benlamonica/drone-show/README.md

# drone-show
The code used for my amateur drone show quad-copters
