benlamonica/drone-show/frame/out/hub.png

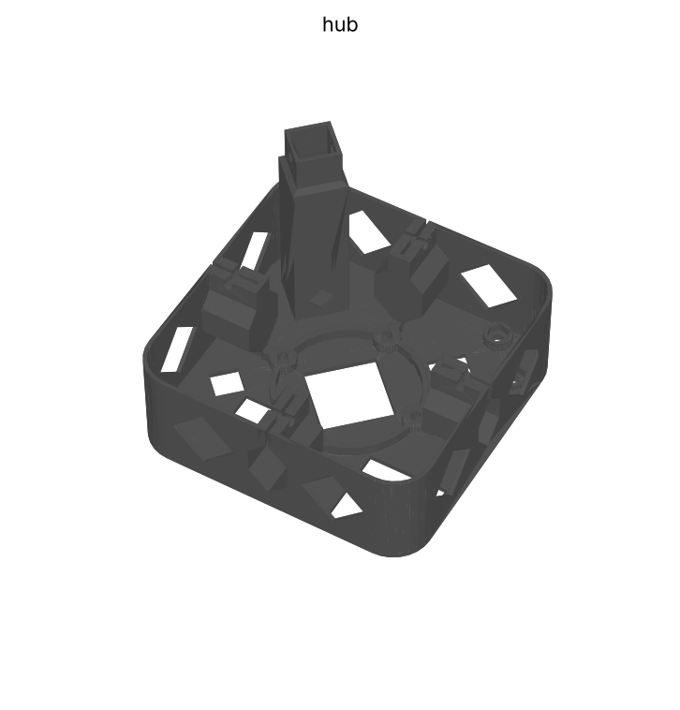
frame/out/hub.png
