benlamonica/drone-show/frame/out/motor_pod.png

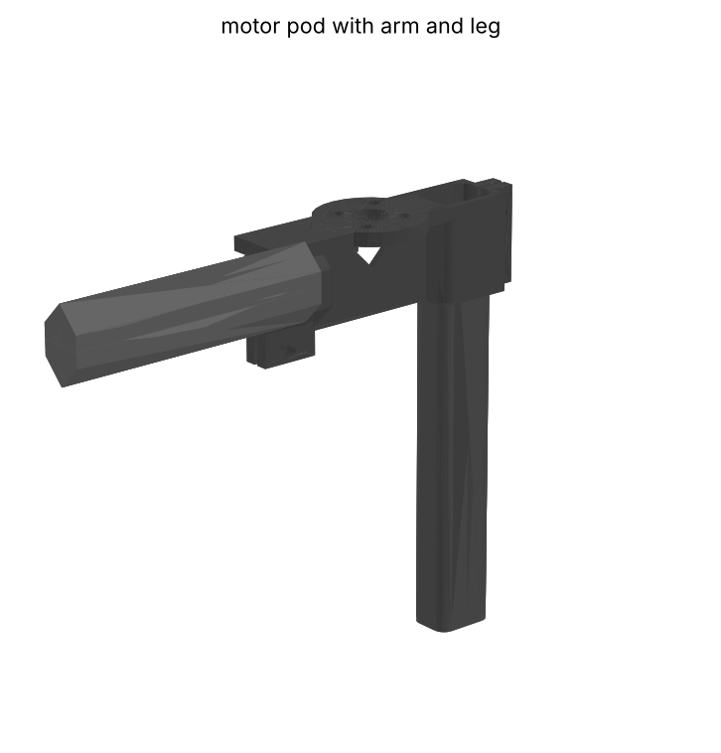
frame/out/motor_pod.png
