benlamonica/drone-show/frame/out/side.png

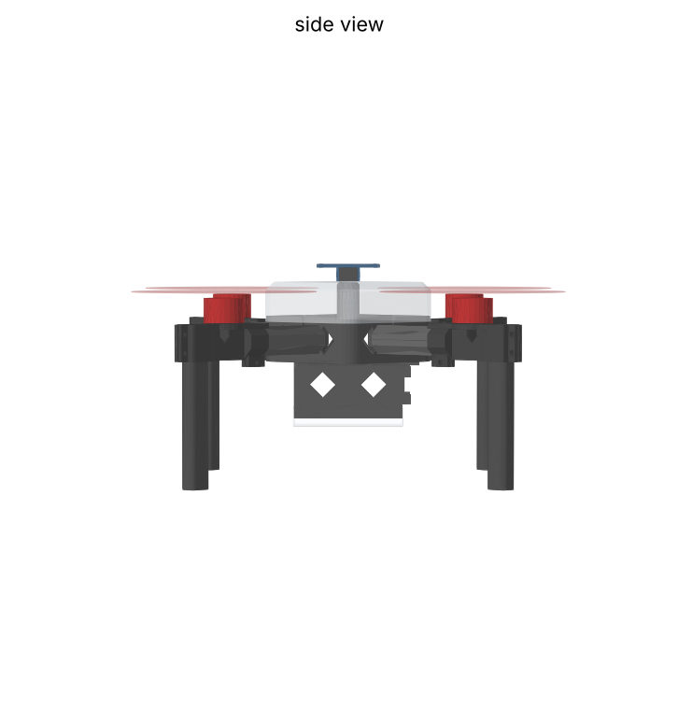
frame/out/side.png
