benlamonica/drone-show/hardware/flight-controller/images/bottom.png

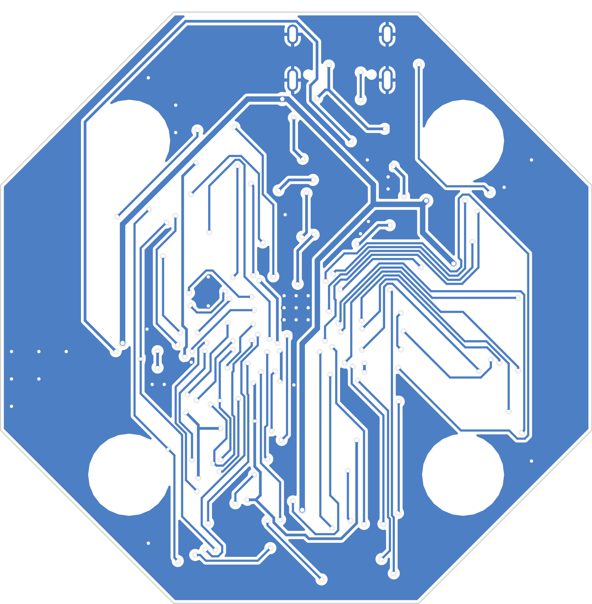
hardware/flight-controller/images/bottom.png
