benlamonica/drone-show/hardware/flight-controller/images/top.png

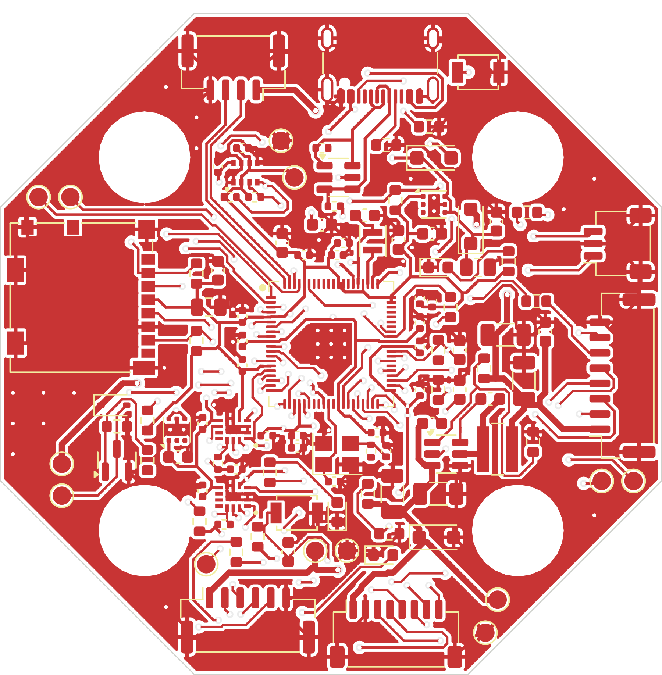
hardware/flight-controller/images/top.png
