benlamonica/drone-show/hardware/light-controller/images/bottom.png

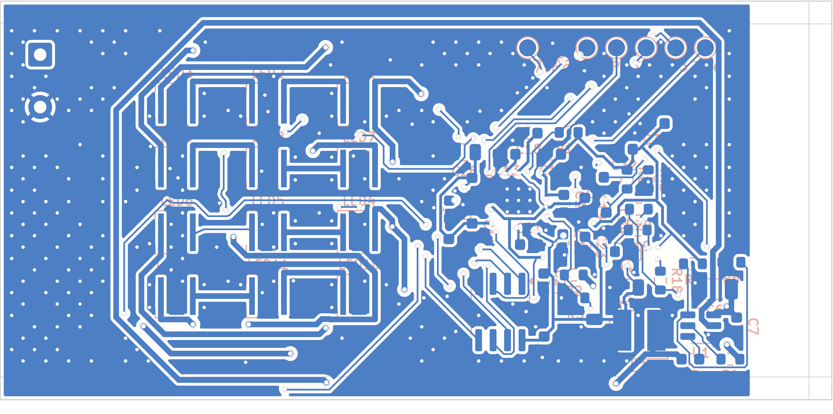
hardware/light-controller/images/bottom.png
