benlamonica/drone-show/hardware/rtk-gps/fab/render-bottom.png

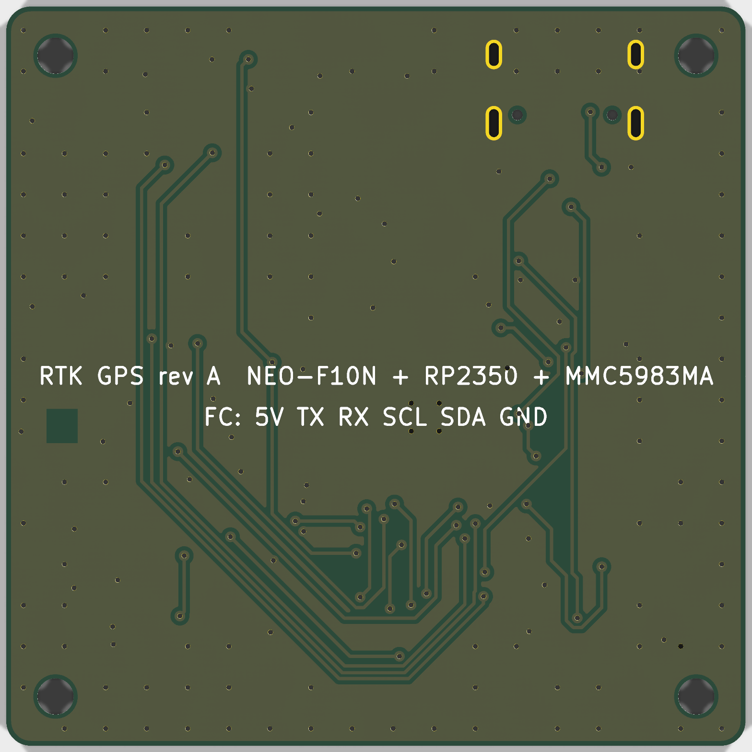
hardware/rtk-gps/fab/render-bottom.png
