benlamonica/drone-show/hardware/rtk-gps/fab/render-top.png

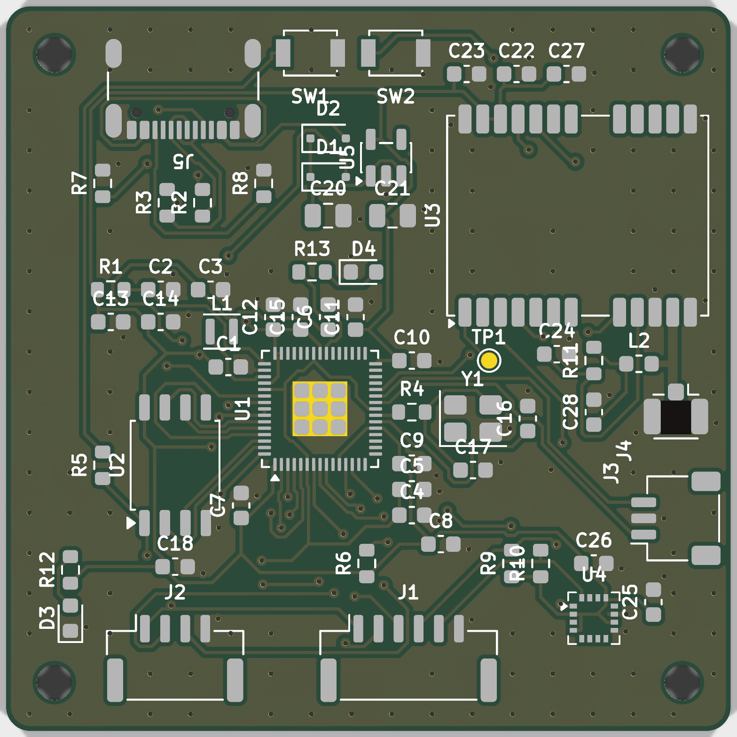
hardware/rtk-gps/fab/render-top.png
