benlamonica/drone-show/hardware/rtk-gps/fab/rtk_gps-bom.csv

Designator | Value | Footprint | MPN | Manufacturer | Mouser | Qty
C1-C3 | 4.7uF | Capacitor_SMD:C_0603_1608Metric | CL10A475MO8NNNC | Samsung | 187-CL10A475MO8NNNC | 3
C4-C15,C18,C22,C27,C28 | 100nF | Capacitor_SMD:C_0603_1608Metric | CC0603KRX7R7BB104 | Yageo | 603-CC603KRX7R7BB104 | 16
C16,C17 | 15pF | Capacitor_SMD:C_0603_1608Metric | CC0603JRNPO9BN150 | Yageo | 603-CC603JRNPO9BN150 | 2
C20,C21 | 10uF | Capacitor_SMD:C_0805_2012Metric | CC0805KKX5R7BB106 | Yageo | 603-CC805KKX5R7BB106 | 2
C23,C26 | 10uF | Capacitor_SMD:C_0603_1608Metric | LMK107BBJ106MALT | Taiyo Yuden | 963-LMK107BBJ106MALT | 2
C24 | 10nF | Capacitor_SMD:C_0603_1608Metric | CC0603KRX7R9BB103 | Yageo | 603-CC603KRX7R9BB103 | 1
C25 | 1uF | Capacitor_SMD:C_0603_1608Metric | CC0603KRX7R7BB105 | Yageo | 603-CC603KRX7R7BB105 | 1
D1,D2 | PMEG4010CEJ | Diode_SMD:D_SOD-323F | PMEG4010CEJ,115 | Nexperia | 771-PMEG4010CEJ-T/R | 2
D3 | green | LED_SMD:LED_0603_1608Metric | LTST-C191KGKT | Lite-On | 859-LTST-C191KGKT | 1
D4 | blue | LED_SMD:LED_0603_1608Metric | LTST-C191TBKT | Lite-On | 859-LTST-C191TBKT | 1
J1 | FC GPS port (Pixhawk GH-6) | Connector_JST:JST_GH_SM06B-GHS-TB_1x06-1MP_P1.25mm_Horizontal | SM06B-GHS-TB(LF)(SN) | JST | 306-SM06BGHSTBLFSN | 1
J2 | AUX UART (corrections in) | Connector_JST:JST_GH_SM04B-GHS-TB_1x04-1MP_P1.25mm_Horizontal | SM04B-GHS-TB(LF)(SN) | JST | 306-SM04BGHSTBLFSN | 1
J3 | SWD (Pi debug probe) | Connector_JST:JST_SH_SM03B-SRSS-TB_1x03-1MP_P1.00mm_Horizontal | SM03B-SRSS-TB(LF)(SN) | JST | 306-SM03BSRSSTBLFSNP | 1
J4 | U.FL antenna | Connector_Coaxial:U.FL_Hirose_U.FL-R-SMT-1_Vertical | U.FL-R-SMT-1(10) | Hirose | 798-U.FL-R-SMT-1-10 | 1
J5 | USB-C (flash + debug) | Connector_USB:USB_C_Receptacle_GCT_USB4105-xx-A_16P_TopMnt_Horizontal | USB4105-GF-A | GCT | 640-USB4105-GF-A | 1
L1 | 3.3uH | Inductor_SMD:L_Murata_DFE201610P | AOTA-B201610S3R3-101-T | Abracon | 815-AB201610S3R3101T | 1
L2 | 27nH | Inductor_SMD:L_0603_1608Metric | LQG18HN27NJ00D | Murata | 81-LQG18HN27NJ00D | 1
R1 | 33R | Resistor_SMD:R_0603_1608Metric | RC0603FR-0733RL | Yageo | 603-RC0603FR-0733RL | 1
R2,R3 | 27R | Resistor_SMD:R_0603_1608Metric | RC0603FR-0727RL | Yageo | 603-RC0603FR-0727RL | 2
R4,R5,R12,R13 | 1k | Resistor_SMD:R_0603_1608Metric | RC0603FR-071KL | Yageo | 603-RC0603FR-071KL | 4
R6 | 10k | Resistor_SMD:R_0603_1608Metric | RC0603FR-0710KL | Yageo | 603-RC0603FR-0710KL | 1
R7,R8 | 5.1k | Resistor_SMD:R_0603_1608Metric | RC0603FR-075K1L | Yageo | 603-RC0603FR-075K1L | 2
R9,R10 | 2.2k | Resistor_SMD:R_0603_1608Metric | RC0603FR-072K2L | Yageo | 603-RC0603FR-072K2L | 2
R11 | 10R | Resistor_SMD:R_0603_1608Metric | RC0603FR-0710RL | Yageo | 603-RC0603FR-0710RL | 1
SW1 | BOOTSEL | Button_Switch_SMD:SW_SPST_B3U-1000P | B3U-1000P | Omron | 653-B3U-1000P | 1
SW2 | RESET | Button_Switch_SMD:SW_SPST_B3U-1000P | B3U-1000P | Omron | 653-B3U-1000P | 1
U1 | RP2350A | Package_DFN_QFN:QFN-60-1EP_7x7mm_P0.4mm_EP3.4x3.4mm | SC1509-A4 (RP2350A) | Raspberry Pi | 358-SC1509 | 1
U2 | W25Q32JVSS | Package_SO:SOIC-8_5.3x5.3mm_P1.27mm | W25Q32JVSSIQ | Winbond | 454-W25Q32JVSSIQ | 1
U3 | NEO-F10N-00B-20 | RF_GPS:ublox_NEO | NEO-F10N-00B-20 | u-blox | 377-NEO-F10N-00B-20 | 1
U4 | MMC5983MA | Package_LGA:LGA-16_3x3mm_P0.5mm | MMC5983MA | MEMSIC | 438-MMC5983MA | 1
U5 | AP2112K-3.3 | Package_TO_SOT_SMD:SOT-23-5 | AP2112K-3.3TRG1 | Diodes Inc | 621-AP2112K-3.3TRG1 | 1
Y1 | 12MHz | Crystal:Crystal_SMD_3225-4Pin_3.2x2.5mm | ABM8-272-T3 | Abracon | 815-ABM8-272-T3 | 1
