benlamonica/drone-show/frame/out/assembly.step

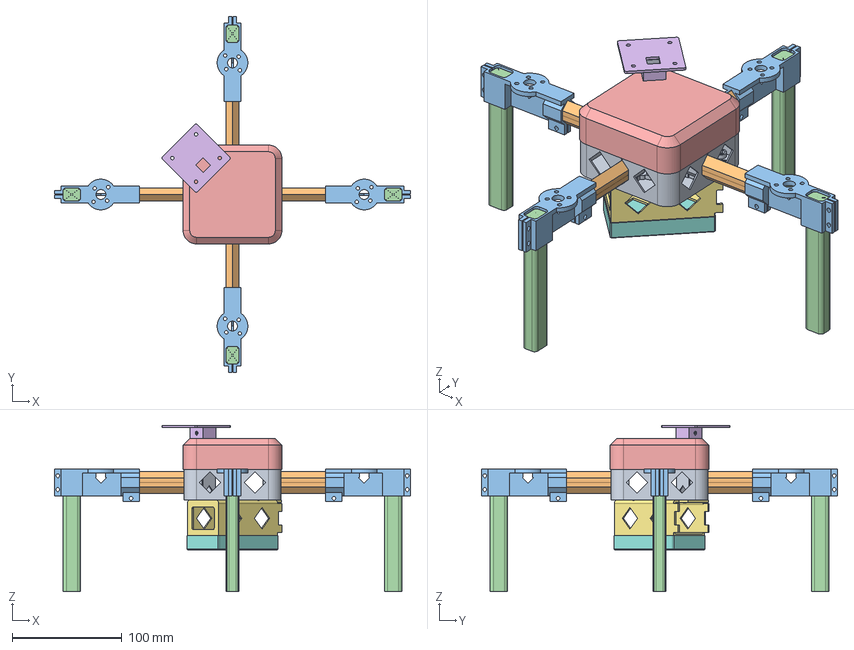
[picture p14: CAD file, 2026-10-25]
frame/out/assembly.step
324.6 x 324.6 x 151.6 mm
