benlamonica/drone-show/frame/out/leg.step

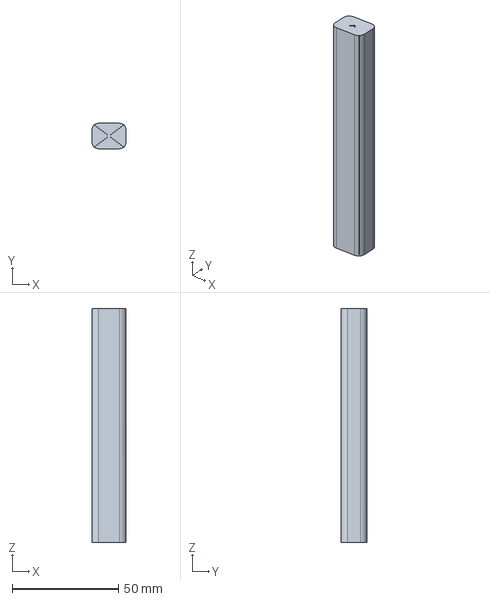
[picture p15: CAD file, 2026-10-25]
frame/out/leg.step
16.0 x 12.0 x 110.0 mm
