benlamonica/drone-show/hardware/rtk-gps/fab/rtk_gps.step

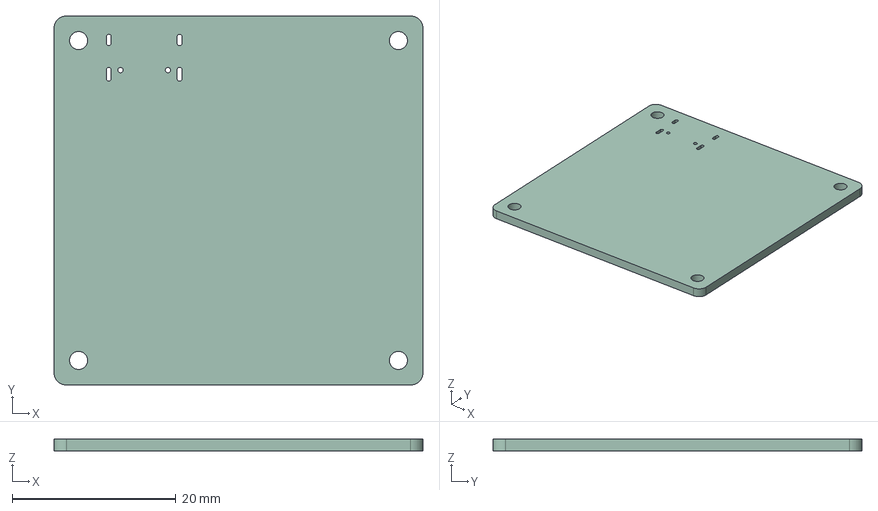
[picture p16: CAD file, 2026-10-25]
hardware/rtk-gps/fab/rtk_gps.step
45.0 x 45.0 x 1.51 mm
