benlamonica/drone-show/frame/out/hub.step

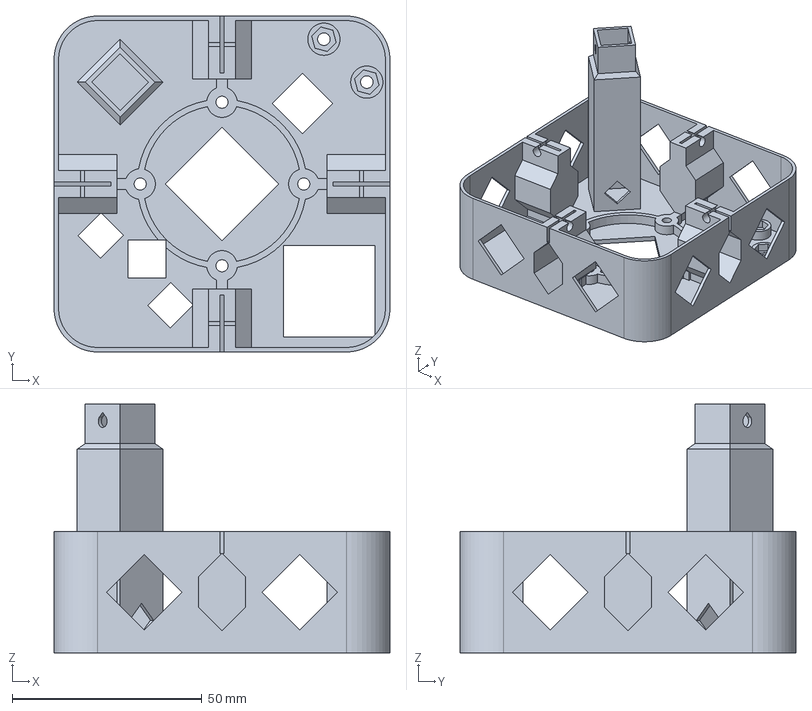
[picture p17: CAD file, 2026-10-25]
frame/out/hub.step
88.6 x 88.6 x 65.6 mm
