benlamonica/drone-show/frame/out/motor_pod.step

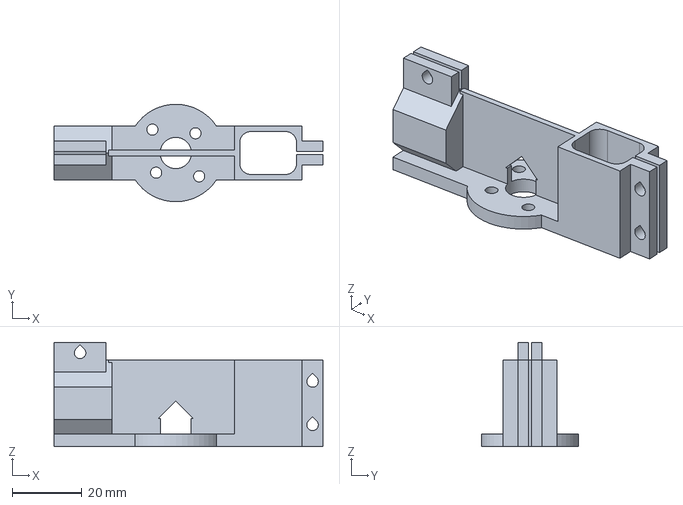
[picture p18: CAD file, 2026-10-25]
frame/out/motor_pod.step
77.3 x 28.0 x 29.9 mm
