benlamonica/drone-show/frame/out/battery_bay.step

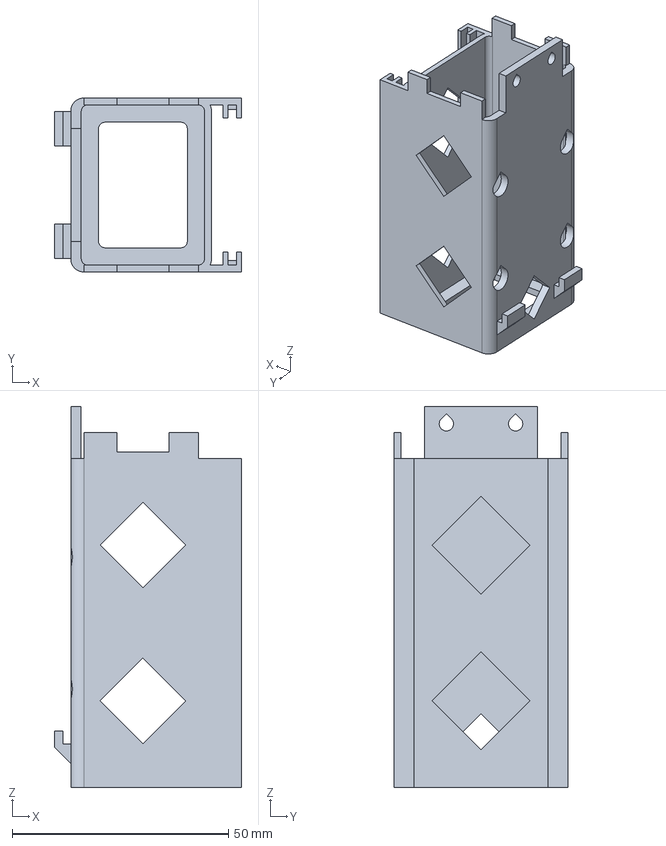
[picture p19: CAD file, 2026-10-25]
frame/out/battery_bay.step
43.3 x 40.2 x 88.0 mm
