benlamonica/drone-show/frame/out/light_diffuser_vase.step

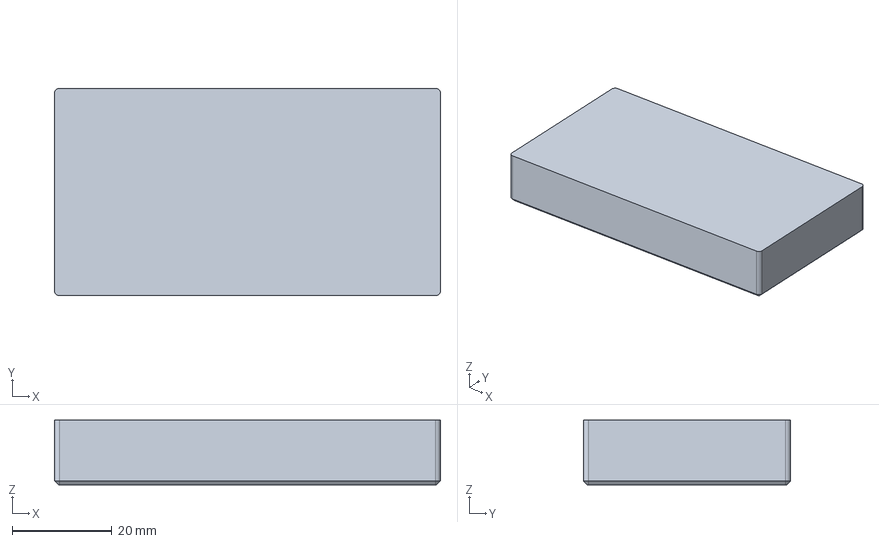
[picture p20: CAD file, 2026-10-25]
frame/out/light_diffuser_vase.step
77.4 x 41.6 x 13.0 mm
