benlamonica/drone-show/frame/out/top_shell_vase.step

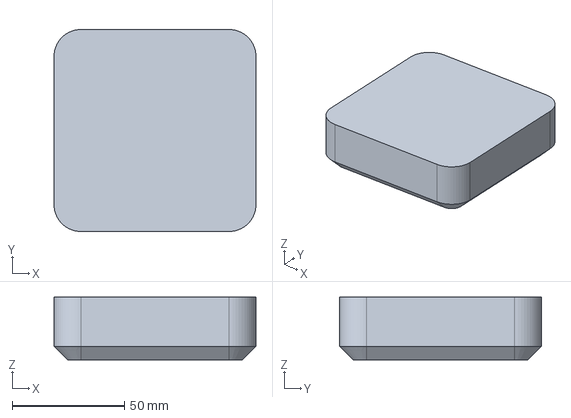
[picture p21: CAD file, 2026-10-25]
frame/out/top_shell_vase.step
90.0 x 90.0 x 28.0 mm
