benlamonica/drone-show/frame/out/light_pcb_outline.dxf

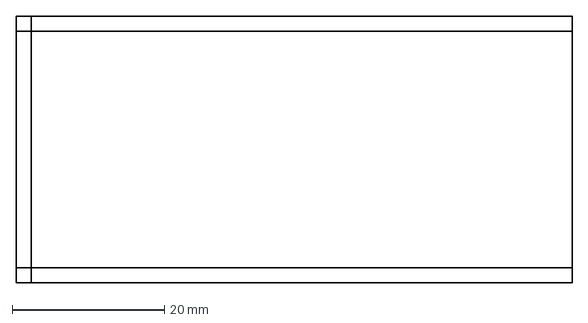
[picture p22: CAD file, 2026-10-25]
frame/out/light_pcb_outline.dxf
73.0 x 35.0 mm
