benlamonica/drone-show/frame/out/arm.step

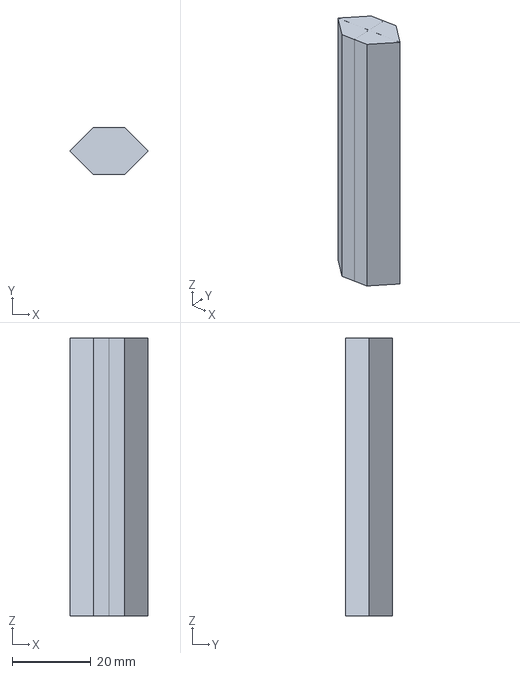
[picture p23: CAD file, 2026-10-25]
frame/out/arm.step
20.0 x 12.0 x 70.7 mm
