benlamonica/drone-show/frame/out/gps_cap.step

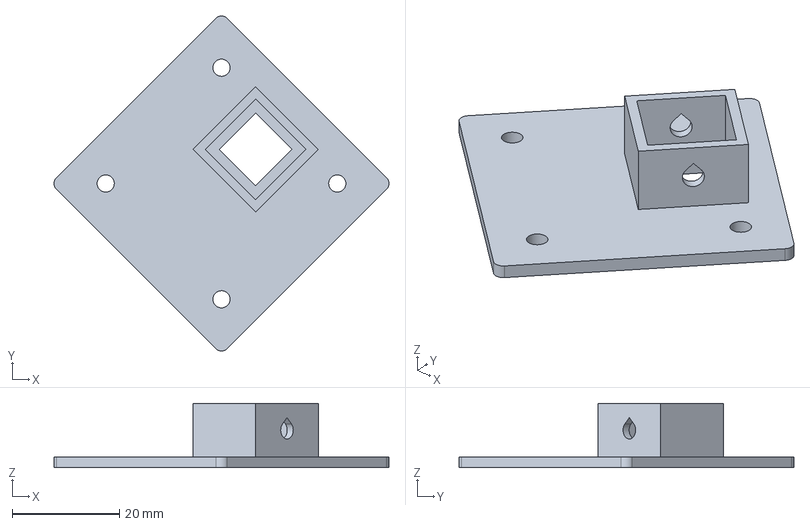
[picture p24: CAD file, 2026-10-25]
frame/out/gps_cap.step
62.4 x 62.4 x 12.0 mm
