benlamonica/drone-show/(list of files, cad)

Other CAD files:
frame/out/arm.stl
frame/out/battery_bay.stl
frame/out/gps_cap.stl
frame/out/hub.stl
frame/out/leg.stl
frame/out/light_diffuser_vase.stl
frame/out/motor_pod.stl
frame/out/top_shell_vase.stl
