benlamonica/drone-show/hardware/rtk-gps/fab/rtk_gps-schematic.pdf

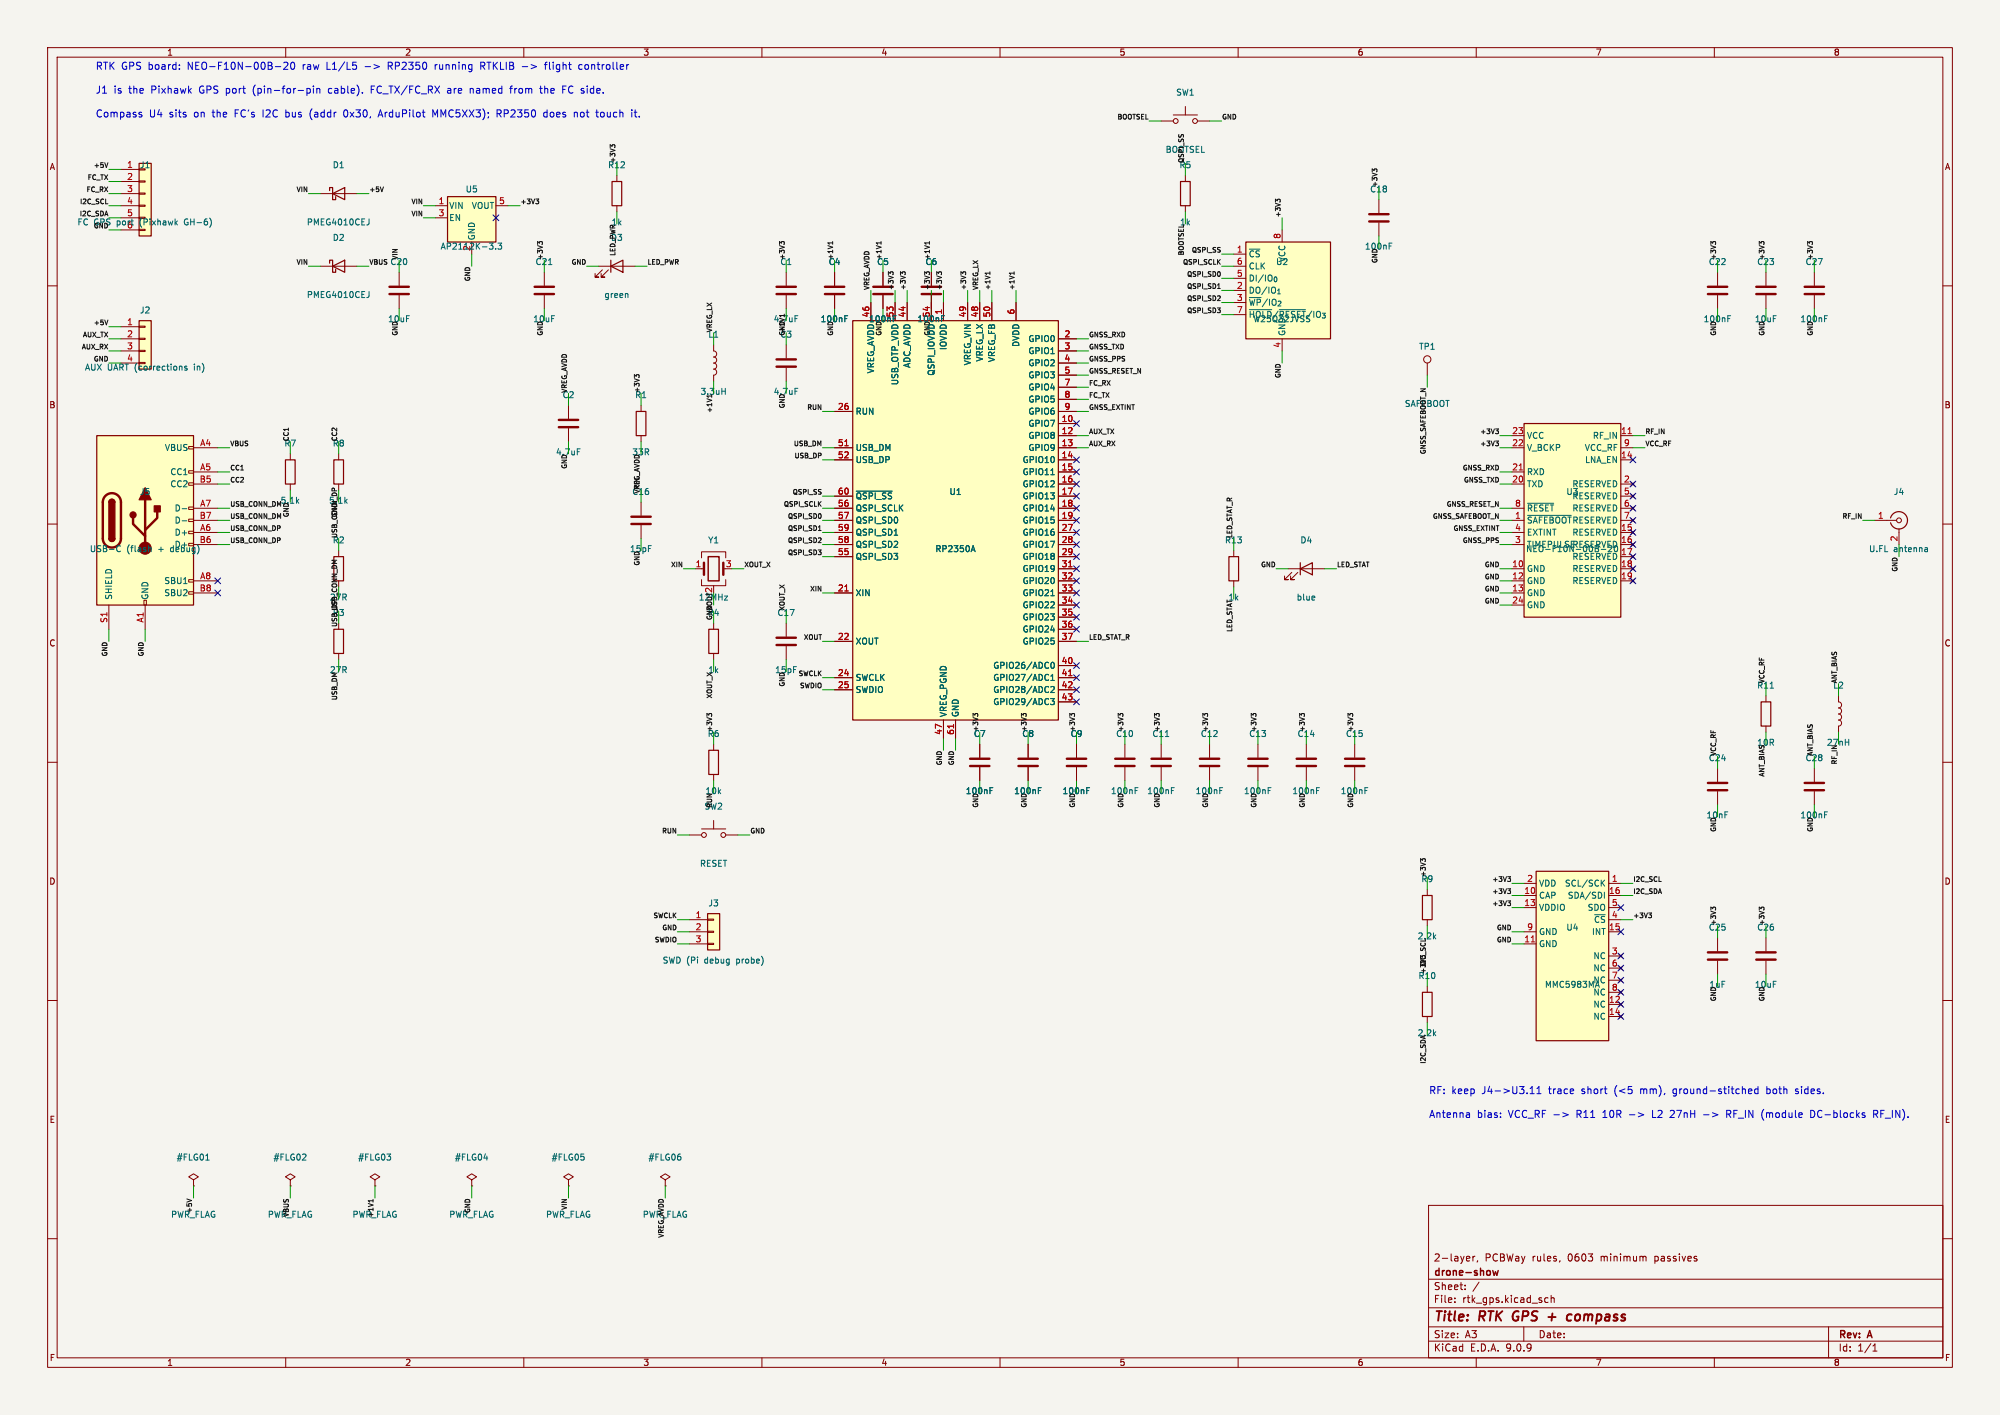
[picture p25: page 1]

6 RUN 26 USB_DM 51 USB_DP 52 ~{QSPI_SS} 60 QSPI_SCLK 56 QSPI_SD0 57 QSPI_SD1 59 QSPI_SD2 58 QSPI_SD3 55 XIN 21 XOUT 22 SWCLK 24 SWDIO 25 ADC_AVDD 44 IOVDD

J3 SWD (Pi debug probe)
SWCLK GND

INT 15 NC 3 NC 6 NC 7 NC 8 NC 12 NC 14 U4 MMC5983MA

File: rtk_gps.kicad_sch Sheet: / drone-show

Id: 1/1 Title: RTK GPS + compass
