benlamonica/drone-show/(list of files, drawings)

Other design files:
hardware/rtk-gps/rtk_gps.dsn
