benlamonica/drone-show/hardware/light-controller/light-controller.kicad_pcb

## KiCad design hardware/light-controller/light-controller.kicad_pcb (2026-11-08)

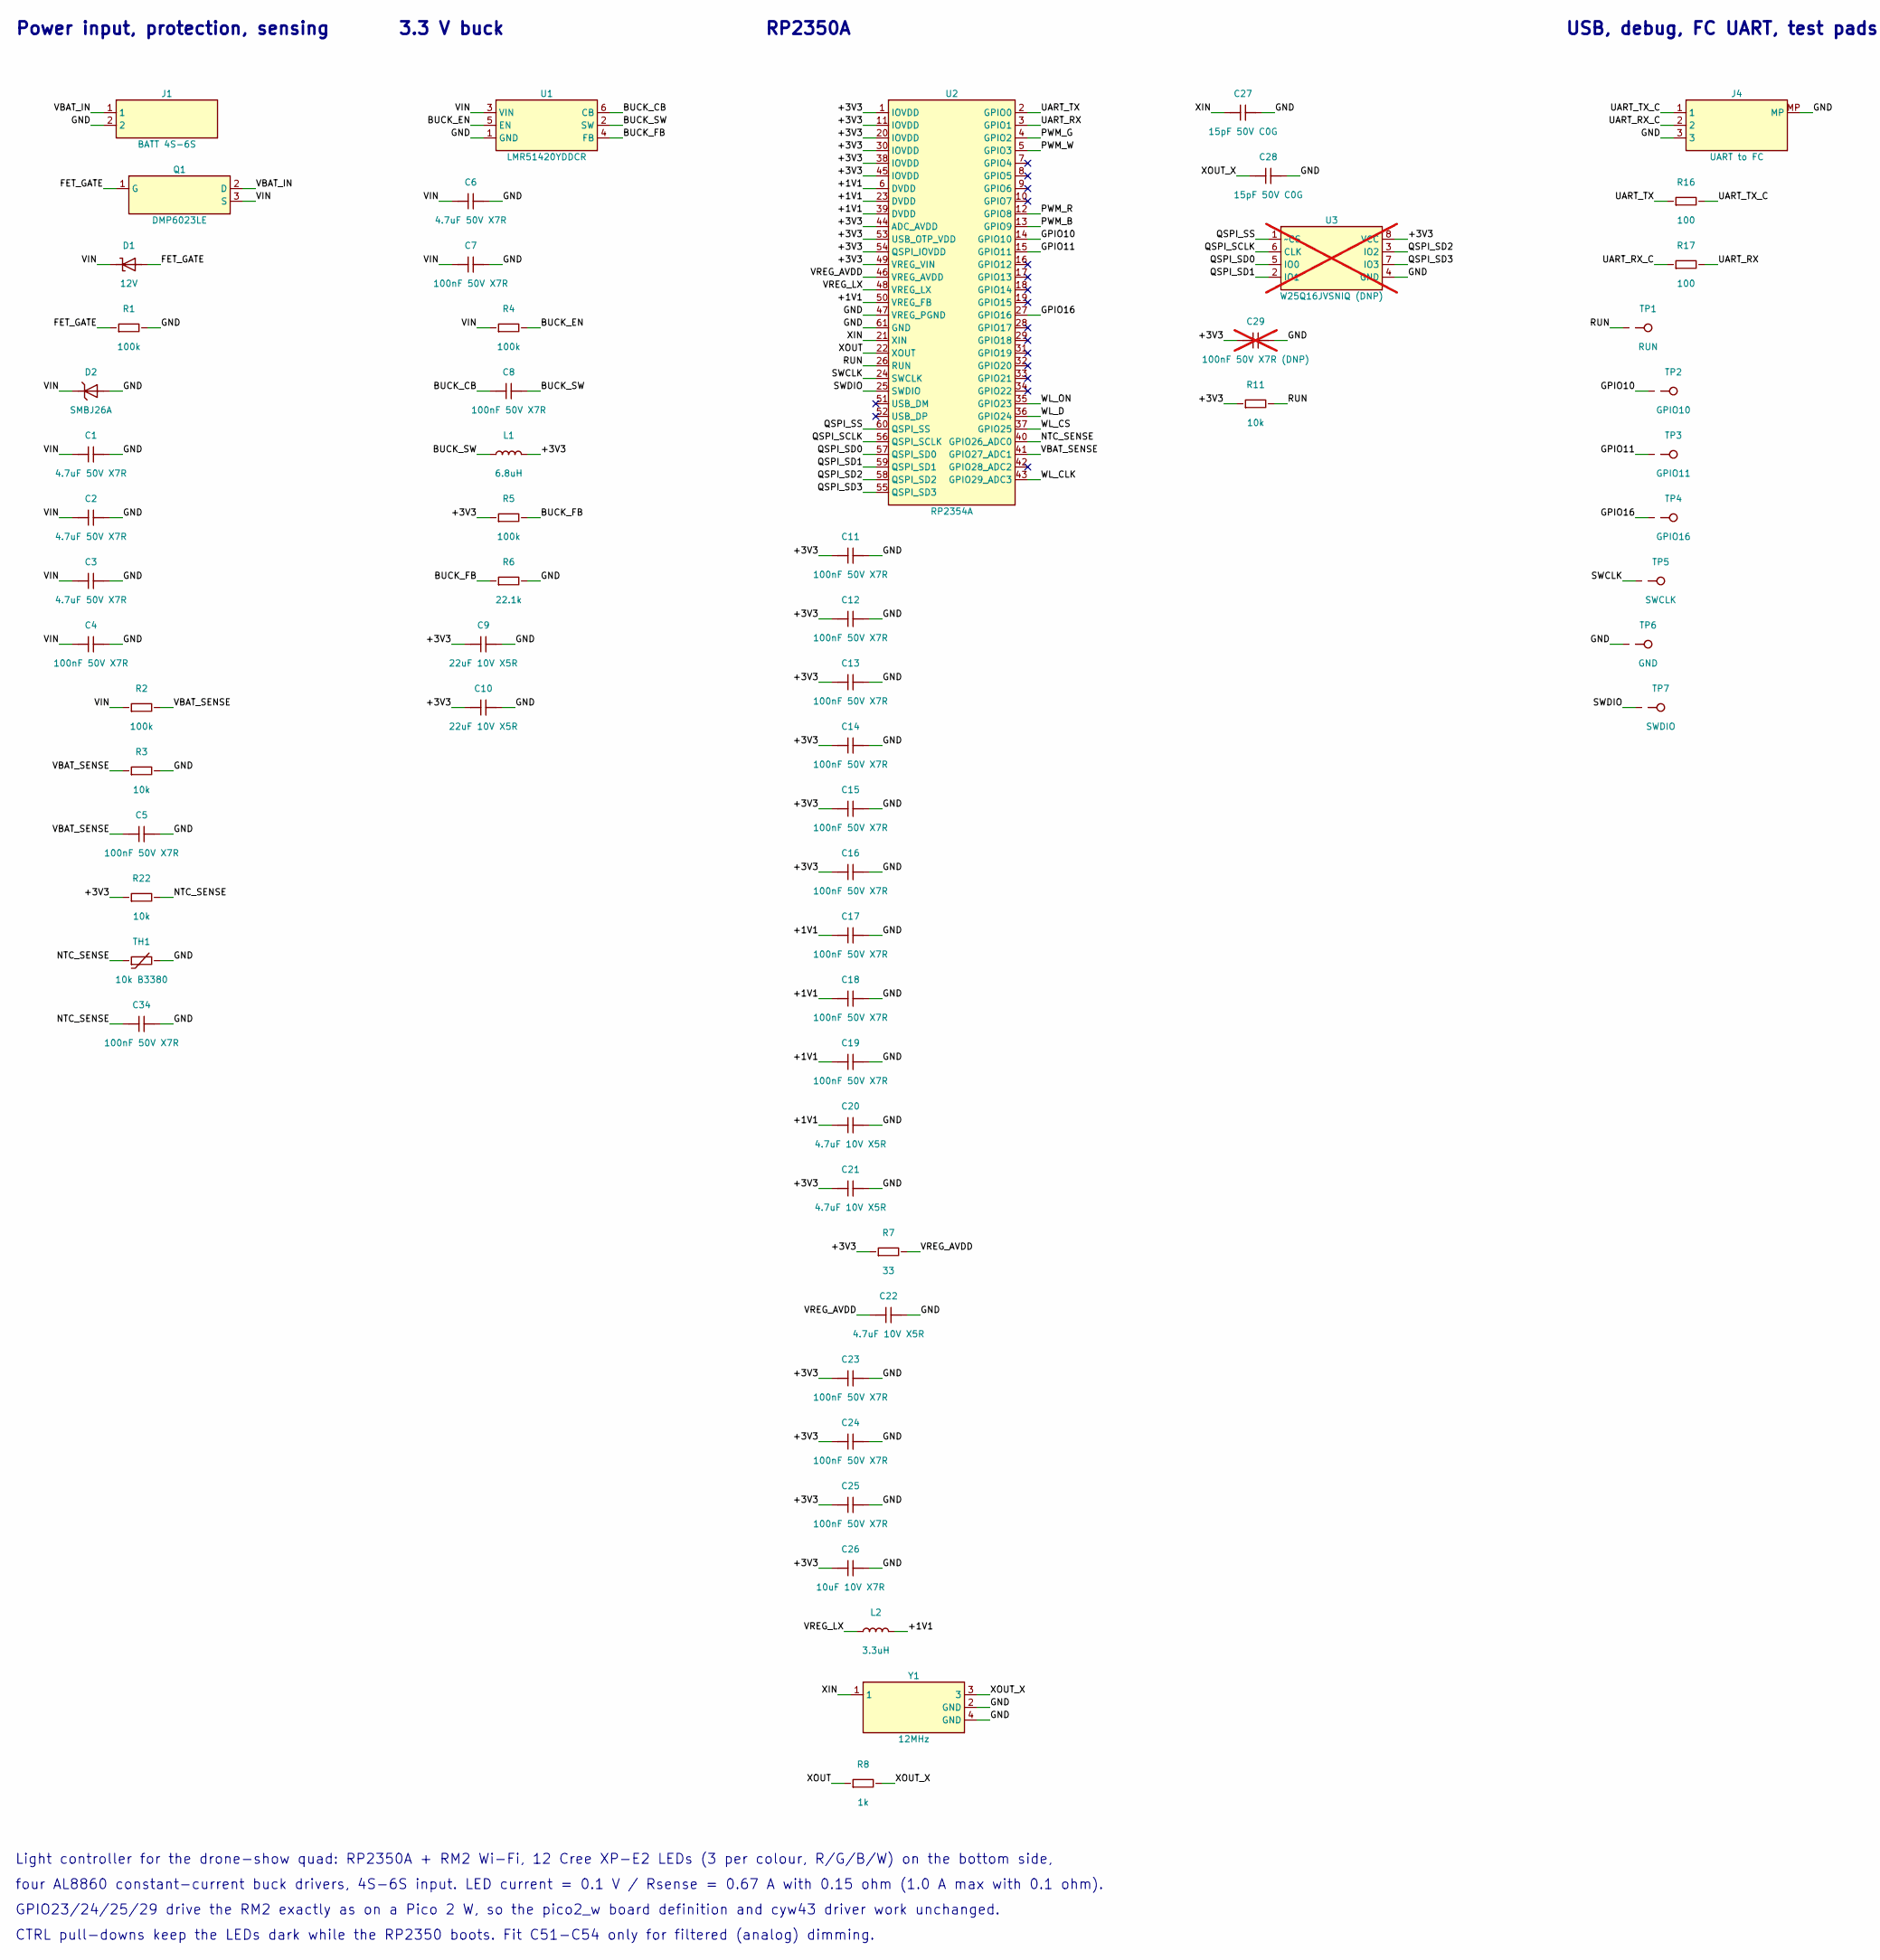
[picture p26: schematic light-controller.kicad_sch, Drone-show light controller, part in row 1, column 1]

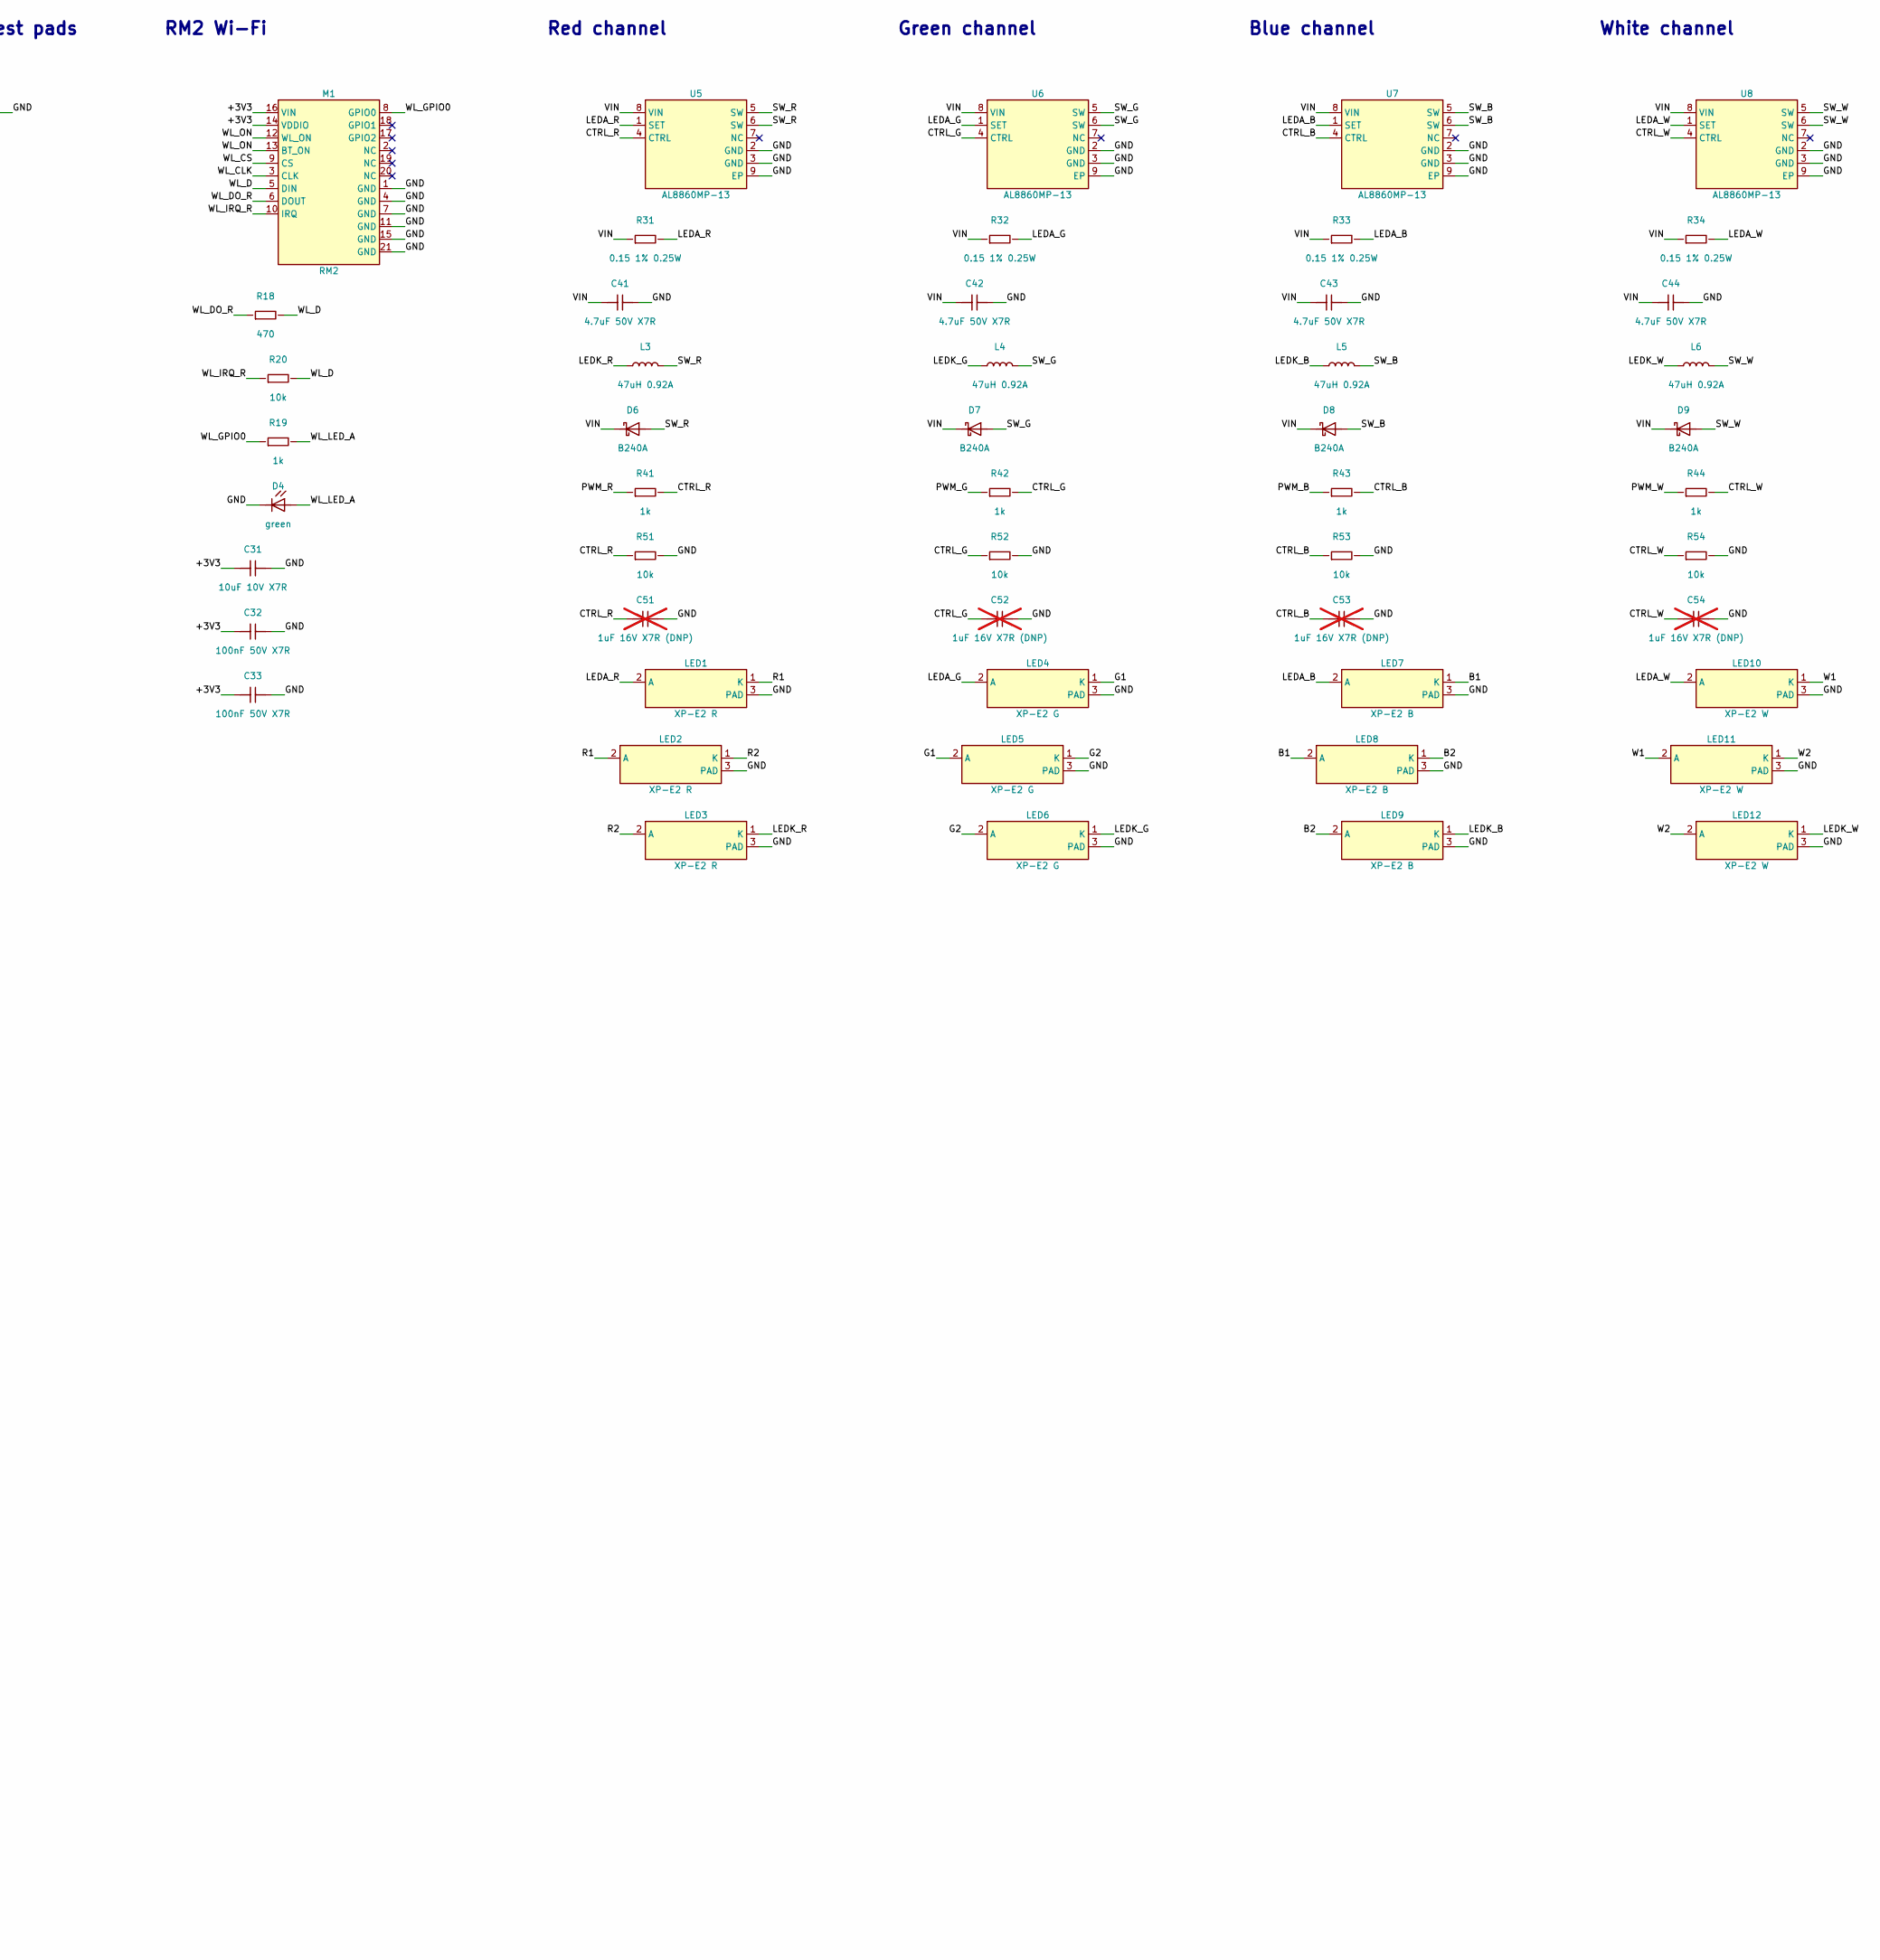
[picture p27: schematic light-controller.kicad_sch, Drone-show light controller, part in row 1, column 2]

Parts:
C1, C2, C3, C6, C41, C42, C43, C44: 4.7uF 50V X7R; C_1206_3216Metric; MPN GRM31CR71H475KA12L
C4, C5, C7, C8, C11, C12, C13, C14, C15, C16, C17, C18, C19, C23, C24, C25, C32, C33, C34: 100nF 50V X7R; C_0603_1608Metric; MPN GRM188R71H104KA93D
C9, C10: 22uF 10V X5R; C_0805_2012Metric; MPN GRM21BR61A226ME44L
C20, C21, C22: 4.7uF 10V X5R; C_0603_1608Metric; MPN GRM188R61A475KE15D
C26, C31: 10uF 10V X7R; C_0805_2012Metric; MPN GRM21BR71A106KA73L
C27, C28: 15pF 50V C0G; C_0603_1608Metric; MPN GRM1885C1H150JA01D
C29: 100nF 50V X7R (DNP); C_0603_1608Metric; MPN GRM188R71H104KA93D; not fitted
C51, C52, C53, C54: 1uF 16V X7R (DNP); C_0603_1608Metric; MPN GRM188R71C105KA12D; not fitted
D1: 12V; D_SOD-123; MPN BZT52C12-7-F
D2: SMBJ26A; D_SMB; MPN SMBJ26A
D4: green; LED_0603_1608Metric; MPN 150060GS75000
D6, D7, D8, D9: B240A; D_SMA; MPN B240A-13-F
J1: BATT 4S-6S; SolderWire-0.5sqmm_1x02_P4.6mm_D0.9mm_OD2.1mm; MPN solder 20 AWG leads
J4: UART to FC; JST_SH_SM03B-SRSS-TB_1x03-1MP_P1.00mm_Horizontal; MPN SM03B-SRSS-TB(LF)(SN)
L1: 6.8uH; L_4020_XAL_TYA; MPN TYA40206R8M-10
L2: 3.3uH; L_Abracon_AOTA-B201610; MPN AOTA-B201610S3R3-101-T
L3, L4, L5, L6: 47uH 0.92A; L_Bourns-SRN6028; MPN SRN6028-470M
LED1, LED2, LED3: XP-E2 R; LED_Cree-XP; MPN XPEBRD-L1-0000-00801 (XP-E2 red, any in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
LED4, LED5, LED6: XP-E2 G; LED_Cree-XP; MPN XPEBGR-L1-0000-00E01 (XP-E2 green)
LED7, LED8, LED9: XP-E2 B; LED_Cree-XP; MPN XPEBBL-L1-0000-00Y01 (XP-E2 blue, any i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
LED10, LED11, LED12: XP-E2 W; LED_Cree-XP; MPN XPEBWT-L1-0000-00D50 (XP-E2 cool white)
M1: RM2; RPi_RM2; MPN SC1169 (Radio Module 2)
Q1: DMP6023LE; SOT-223-3_TabPin2; MPN DMP6023LE-13
R1, R2, R4, R5: 100k; R_0603_1608Metric; MPN RC0603FR-07100KL
R3, R11, R20, R22, R51, R52, R53, R54: 10k; R_0603_1608Metric; MPN RC0603FR-0710KL
R6: 22.1k; R_0603_1608Metric; MPN RC0603FR-0722K1L
R7: 33; R_0603_1608Metric; MPN RC0603FR-0733RL
R8, R19, R41, R42, R43, R44: 1k; R_0603_1608Metric; MPN RC0603FR-071KL
R16, R17: 100; R_0603_1608Metric; MPN RC0603FR-07100RL
R18: 470; R_0603_1608Metric; MPN RC0603FR-07470RL
R31, R32, R33, R34: 0.15 1% 0.25W; R_1206_3216Metric; MPN WSL1206R1500FEA
TH1: 10k B3380; R_0603_1608Metric; MPN NCP18XH103F03RB
TP1: RUN; TestPoint_Pad_D1.5mm; MPN test pad
TP2: GPIO10; TestPoint_Pad_D1.5mm; MPN test pad
TP3: GPIO11; TestPoint_Pad_D1.5mm; MPN test pad
TP4: GPIO16; TestPoint_Pad_D1.5mm; MPN test pad
TP5: SWCLK; TestPoint_Pad_D1.5mm; MPN test pad
TP6: GND; TestPoint_Pad_D1.5mm; MPN test pad
TP7: SWDIO; TestPoint_Pad_D1.5mm; MPN test pad
U1: LMR51420YDDCR; SOT-23-6; MPN LMR51420YDDCR
U2: RP2354A; RP2350A_QFN-60_7x7mm_P0.4mm; MPN RP2354A
U3: W25Q16JVSNIQ (DNP); SOIC-8_3.9x4.9mm_P1.27mm; MPN W25Q16JVSNIQ; not fitted
U5, U6, U7, U8: AL8860MP-13; MSOP-8-1EP_3x3mm_P0.65mm_EP1.68x1.88mm; MPN AL8860MP-13
Y1: 12MHz; Crystal_SMD_3225-4Pin_3.2x2.5mm; MPN ABM8-272-T3

Connections:
/+1V1: C17.1, C18.1, C19.1, C20.1, L2.2, U2.6 (DVDD), U2.23 (DVDD), U2.39 (DVDD), U2.50 (VREG_FB)
/+3V3: C9.1, C10.1, C11.1, C12.1, C13.1, C14.1, C15.1, C16.1, C21.1, C23.1, C24.1, C25.1, C26.1, C29.1, C31.1, C32.1, C33.1, L1.2, M1.14 (VDDIO), M1.16 (VIN), R5.1, R7.1, R11.1, R22.1, U2.1 (IOVDD), U2.11 (IOVDD), U2.20 (IOVDD), U2.30 (IOVDD), U2.38 (IOVDD), U2.44 (ADC_AVDD), U2.45 (IOVDD), U2.49 (VREG_VIN), U2.53 (USB_OTP_VDD), U2.54 (QSPI_IOVDD), U3.8 (VCC)
/B1: LED7.1 (K), LED8.2 (A)
/B2: LED8.1 (K), LED9.2 (A)
/BUCK_CB: C8.1, U1.6 (CB)
/BUCK_EN: R4.2, U1.5 (EN)
/BUCK_FB: R5.2, R6.1, U1.4 (FB)
/BUCK_SW: C8.2, L1.1, U1.2 (SW)
/CTRL_B: C53.1, R43.2, R53.1, U7.4 (CTRL)
/CTRL_G: C52.1, R42.2, R52.1, U6.4 (CTRL)
/CTRL_R: C51.1, R41.2, R51.1, U5.4 (CTRL)
/CTRL_W: C54.1, R44.2, R54.1, U8.4 (CTRL)
/FET_GATE: D1.2 (A), Q1.1 (G), R1.1
/G1: LED4.1 (K), LED5.2 (A)
/G2: LED5.1 (K), LED6.2 (A)
/GND: C1.2, C2.2, C3.2, C4.2, C5.2, C6.2, C7.2, C9.2, C10.2, C11.2, C12.2, C13.2, C14.2, C15.2, C16.2, C17.2, C18.2, C19.2, C20.2, C21.2, C22.2, C23.2, C24.2, C25.2, C26.2, C27.2, C28.2, C29.2, C31.2, C32.2, C33.2, C34.2, C41.2, C42.2, C43.2, C44.2, C51.2, C52.2, C53.2, C54.2, D2.2 (A), D4.1 (K), J1.2, J4.3, J4.MP, LED1.3 (PAD), LED2.3 (PAD), LED3.3 (PAD), LED4.3 (PAD), LED5.3 (PAD), LED6.3 (PAD), LED7.3 (PAD), LED8.3 (PAD), LED9.3 (PAD), LED10.3 (PAD), LED11.3 (PAD), LED12.3 (PAD), M1.1 (GND), M1.4 (GND), M1.7 (GND), M1.11 (GND), M1.15 (GND), M1.21 (GND), R1.2, R3.2, R6.2, R51.2, R52.2, R53.2, R54.2, TH1.2, TP6.1, U1.1 (GND), U2.47 (VREG_PGND), U2.61 (GND), U3.4 (GND), U5.2 (GND), U5.3 (GND), U5.9 (EP), U6.2 (GND), U6.3 (GND), U6.9 (EP), U7.2 (GND), U7.3 (GND), U7.9 (EP), U8.2 (GND), U8.3 (GND), U8.9 (EP), Y1.2 (GND), Y1.4 (GND); also elsewhere on the board
/GPIO10: TP2.1, U2.14 (GPIO10); also elsewhere on the board
/GPIO11: TP3.1, U2.15 (GPIO11); also elsewhere on the board
/GPIO16: TP4.1, U2.27 (GPIO16); also elsewhere on the board
/LEDA_B: LED7.2 (A), R33.2, U7.1 (SET)
/LEDA_G: LED4.2 (A), R32.2, U6.1 (SET)
/LEDA_R: LED1.2 (A), R31.2, U5.1 (SET)
/LEDA_W: LED10.2 (A), R34.2, U8.1 (SET)
/LEDK_B: L5.1, LED9.1 (K)
/LEDK_G: L4.1, LED6.1 (K)
/LEDK_R: L3.1, LED3.1 (K)
/LEDK_W: L6.1, LED12.1 (K)
/NTC_SENSE: C34.1, R22.2, TH1.1, U2.40 (GPIO26_ADC0)
/PWM_B: R43.1, U2.13 (GPIO9)
/PWM_G: R42.1, U2.4 (GPIO2)
/PWM_R: R41.1, U2.12 (GPIO8)
/PWM_W: R44.1, U2.5 (GPIO3)
/QSPI_SCLK: U2.56 (QSPI_SCLK), U3.6 (CLK)
/QSPI_SD0: U2.57 (QSPI_SD0), U3.5 (IO0)
/QSPI_SD1: U2.59 (QSPI_SD1), U3.2 (IO1)
/QSPI_SD2: U2.58 (QSPI_SD2), U3.3 (IO2)
/QSPI_SD3: U2.55 (QSPI_SD3), U3.7 (IO3)
/QSPI_SS: U2.60 (QSPI_SS), U3.1 (~CS)
/R1: LED1.1 (K), LED2.2 (A)
/R2: LED2.1 (K), LED3.2 (A)
/RUN: R11.2, TP1.1, U2.26 (RUN); also elsewhere on the board
/SWCLK: TP5.1, U2.24 (SWCLK); also elsewhere on the board
/SWDIO: TP7.1, U2.25 (SWDIO); also elsewhere on the board
/SW_B: D8.2 (A), L5.2, U7.5 (SW), U7.6 (SW)
/SW_G: D7.2 (A), L4.2, U6.5 (SW), U6.6 (SW)
/SW_R: D6.2 (A), L3.2, U5.5 (SW), U5.6 (SW)
/SW_W: D9.2 (A), L6.2, U8.5 (SW), U8.6 (SW)
/UART_RX: R17.2, U2.3 (GPIO1)
/UART_RX_C: J4.2, R17.1
/UART_TX: R16.1, U2.2 (GPIO0)
/UART_TX_C: J4.1, R16.2
/VBAT_IN: J1.1, Q1.2 (D)
/VBAT_SENSE: C5.1, R2.2, R3.1, U2.41 (GPIO27_ADC1)
/VIN: C1.1, C2.1, C3.1, C4.1, C6.1, C7.1, C41.1, C42.1, C43.1, C44.1, D1.1 (K), D2.1 (K), D6.1 (K), D7.1 (K), D8.1 (K), D9.1 (K), Q1.3 (S), R2.1, R4.1, R31.1, R32.1, R33.1, R34.1, U1.3 (VIN), U5.8 (VIN), U6.8 (VIN), U7.8 (VIN), U8.8 (VIN)
/VREG_AVDD: C22.1, R7.2, U2.46 (VREG_AVDD)
/VREG_LX: L2.1, U2.48 (VREG_LX)
/W1: LED10.1 (K), LED11.2 (A)
/W2: LED11.1 (K), LED12.2 (A)
/WL_CLK: M1.3 (CLK), U2.43 (GPIO29_ADC3)
/WL_CS: M1.9 (CS), U2.37 (GPIO25)
/WL_D: M1.5 (DIN), R18.2, R20.2, U2.36 (GPIO24)
/WL_DO_R: M1.6 (DOUT), R18.1
/WL_GPIO0: M1.8 (GPIO0), R19.1
/WL_IRQ_R: M1.10 (IRQ), R20.1
/WL_LED_A: D4.2 (A), R19.2
/WL_ON: M1.12 (WL_ON), M1.13 (BT_ON), U2.35 (GPIO23)
/XIN: C27.1, U2.21 (XIN), Y1.1
/XOUT: R8.1, U2.22 (XOUT)
/XOUT_X: C28.1, R8.2, Y1.3

Notes on the sheet:
Power input, protection, sensing
3.3 V buck
RP2350A
USB, debug, FC UART, test pads
RM2 Wi-Fi
Red channel
Green channel
Blue channel
White channel
Light controller for the drone-show quad: RP2350A + RM2 Wi-Fi, 12 Cree XP-E2 LEDs (3 per colour, R/G/B/W) on the bottom side,
four AL8860 constant-current buck drivers, 4S-6S input. LED current = 0.1 V / Rsense = 0.67 A with 0.15 ohm (1.0 A max with 0.1 ohm).
GPIO23/24/25/29 drive the RM2 exactly as on a Pico 2 W, so the pico2_w board definition and cyw43 driver work unchanged.
CTRL pull-downs keep the LEDs dark while the RP2350 boots. Fit C51-C54 only for filtered (analog) dimming.

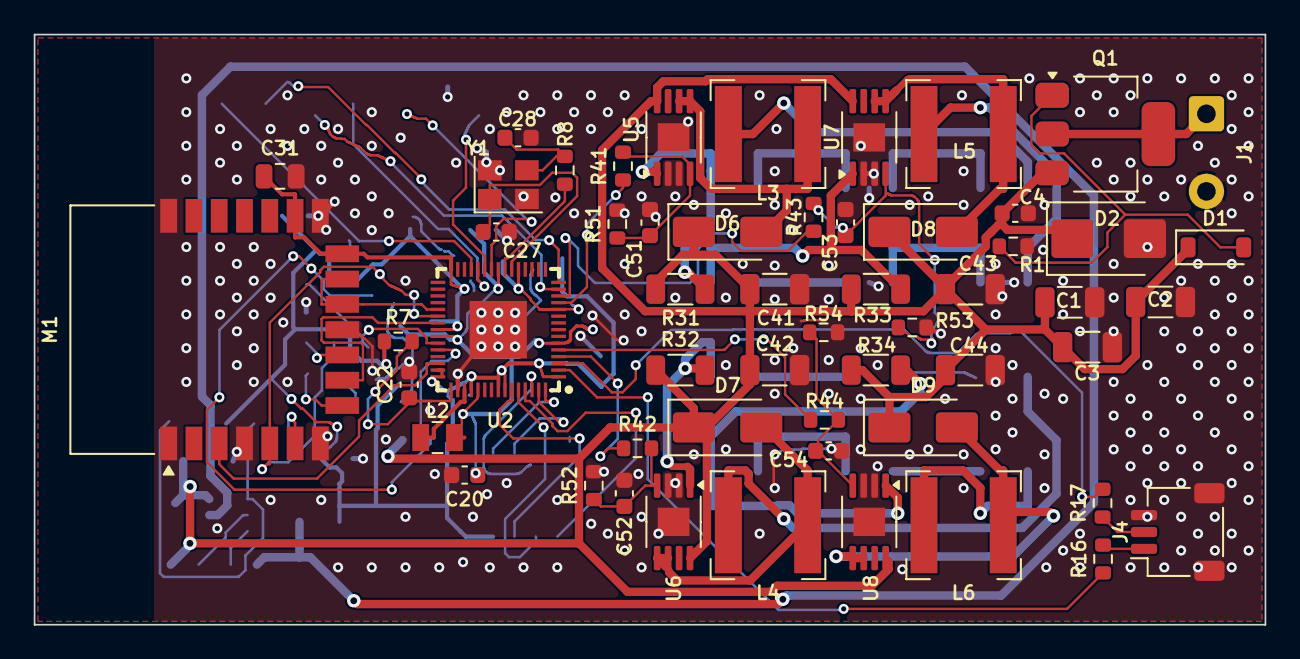
[picture p28: board light-controller.kicad_pcb from above]

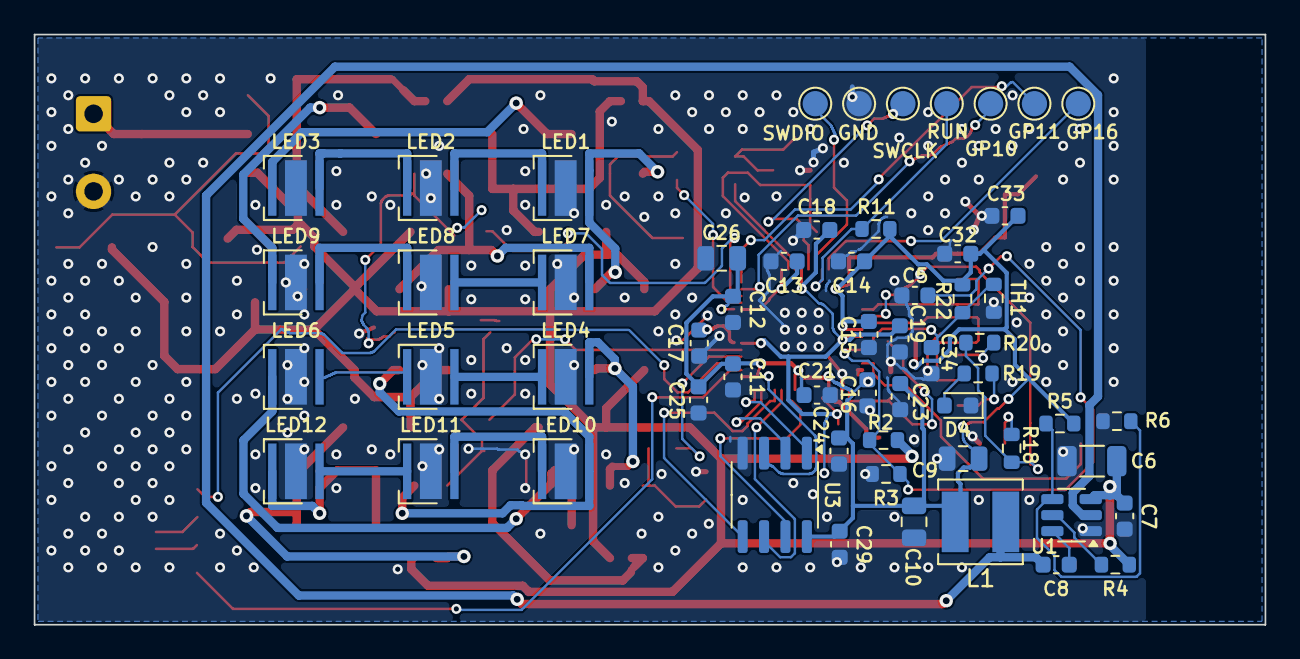
[picture p29: board light-controller.kicad_pcb from below]

Board: 2 copper layers, 73.0 x 35.0 mm, 113 parts (58 on the bottom side), 69 nets.

Other parts of the board:
GND: GND; TestPoint_Pad_D1.5mm
GP10: GPIO10; TestPoint_Pad_D1.5mm
GP11: GPIO11; TestPoint_Pad_D1.5mm
GP16: GPIO16; TestPoint_Pad_D1.5mm
RUN: RUN; TestPoint_Pad_D1.5mm
SWCLK: SWCLK; TestPoint_Pad_D1.5mm
SWDIO: SWDIO; TestPoint_Pad_D1.5mm

Their connections:
/GND: GND.1; also elsewhere on the board
/GPIO10: GP10.1; also elsewhere on the board
/GPIO11: GP11.1; also elsewhere on the board
/GPIO16: GP16.1; also elsewhere on the board
/RUN: RUN.1; also elsewhere on the board
/SWCLK: SWCLK.1; also elsewhere on the board
/SWDIO: SWDIO.1; also elsewhere on the board
