benlamonica/drone-show/hardware/flight-controller/show-fc.kicad_pcb

## KiCad design hardware/flight-controller/show-fc.kicad_pcb (2026-11-08)

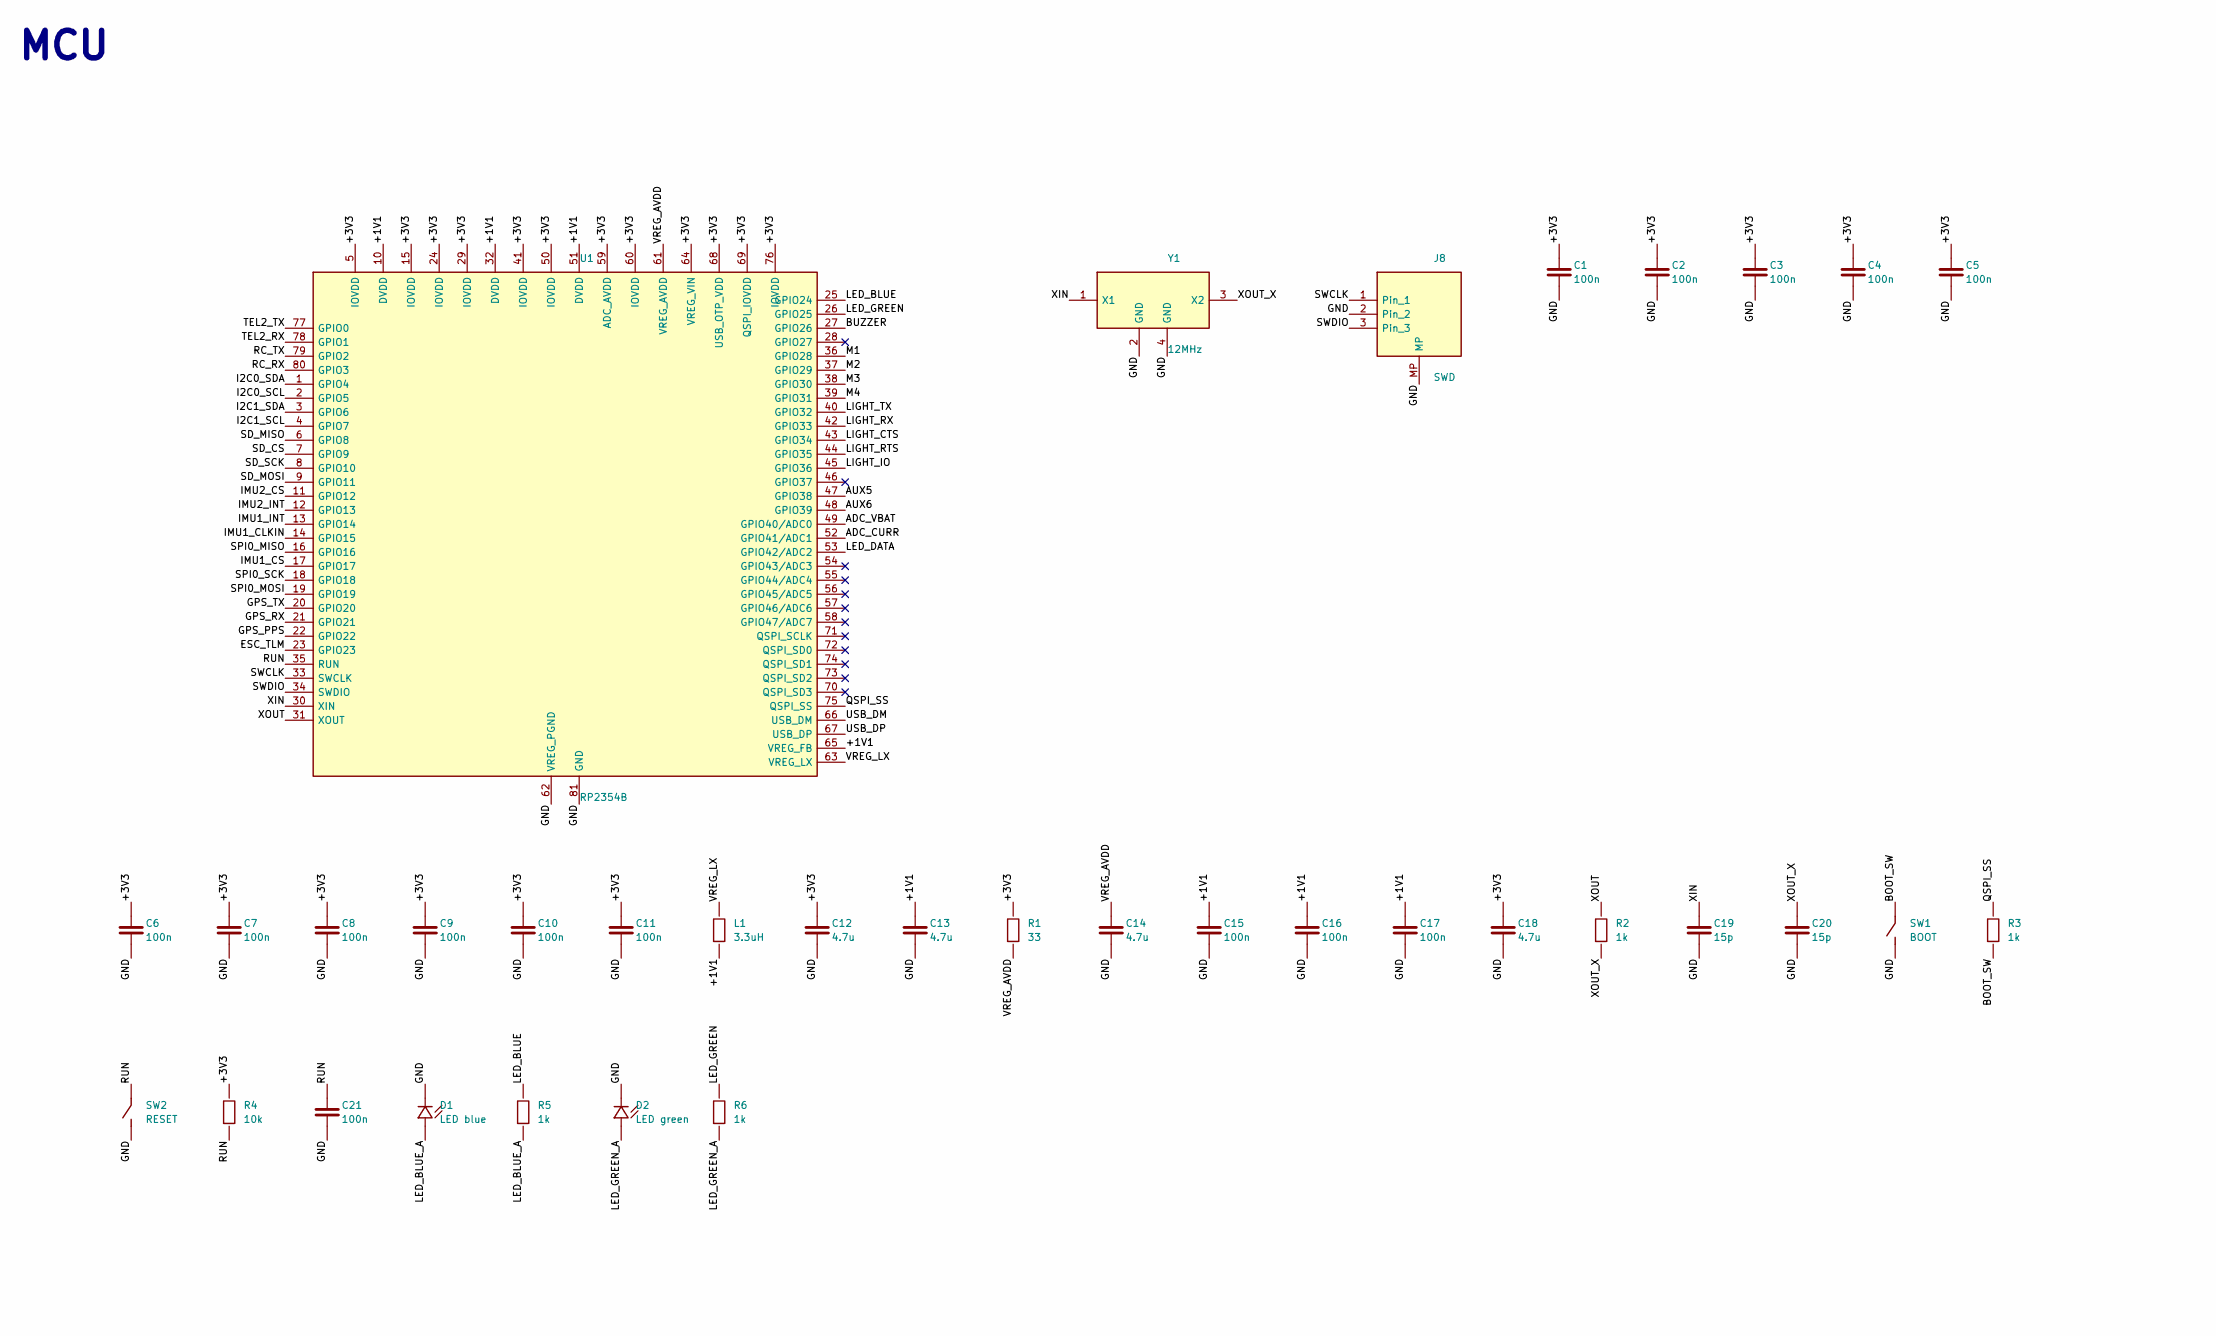
[picture p30: schematic show-fc.kicad_sch, Show FC (2-layer, RP2354B), part in row 1, column 1]

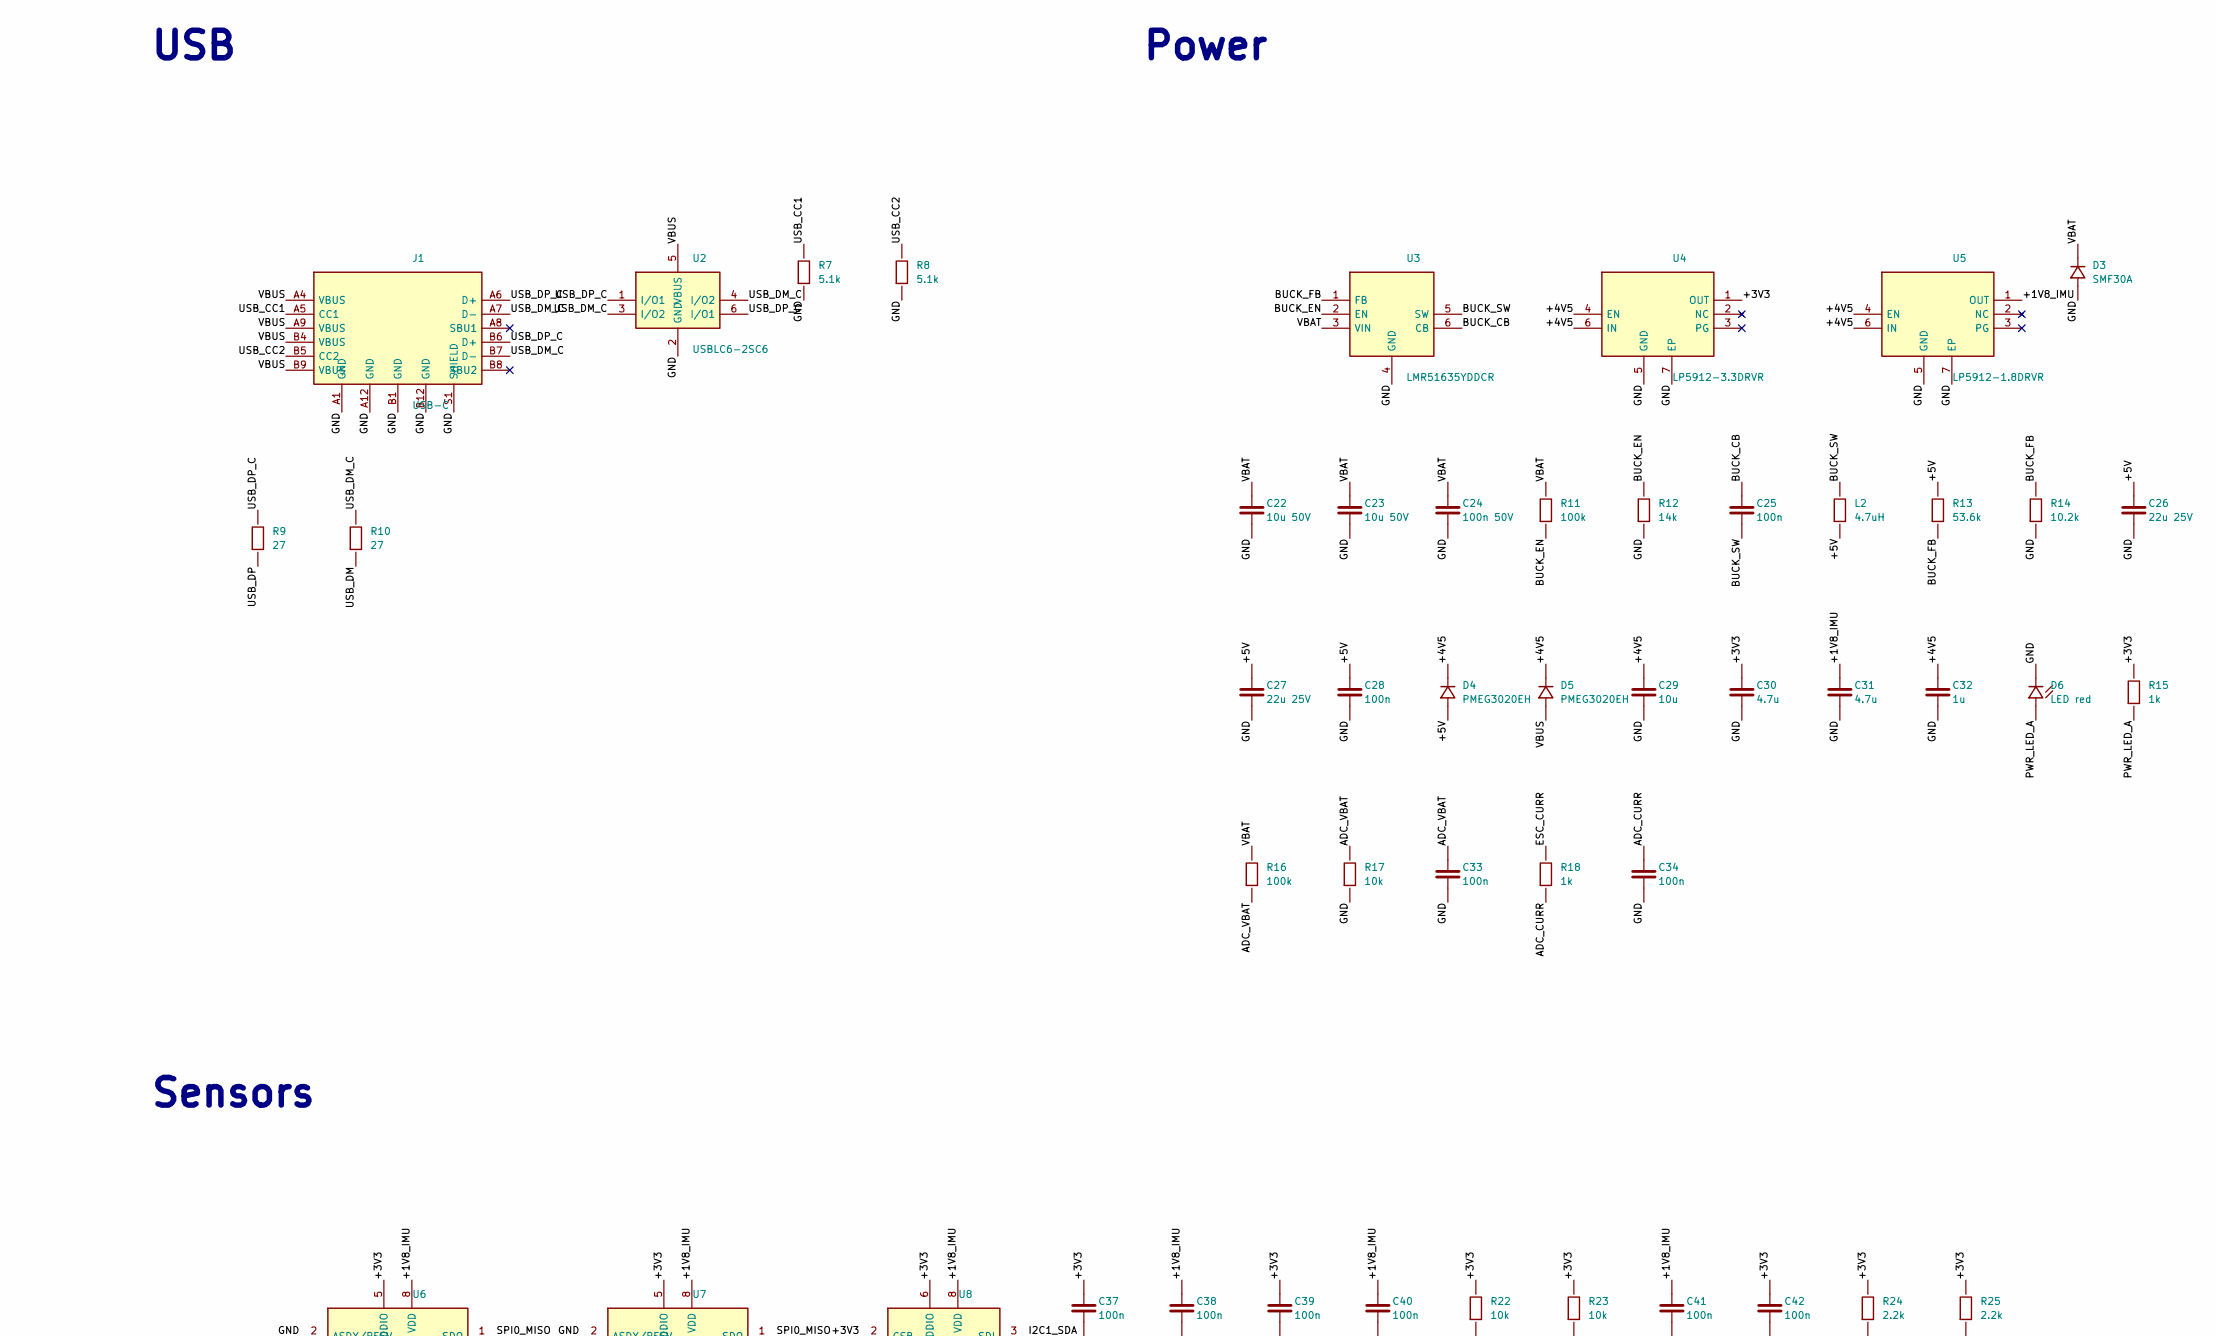
[picture p31: schematic show-fc.kicad_sch, Show FC (2-layer, RP2354B), part in row 1, column 2]

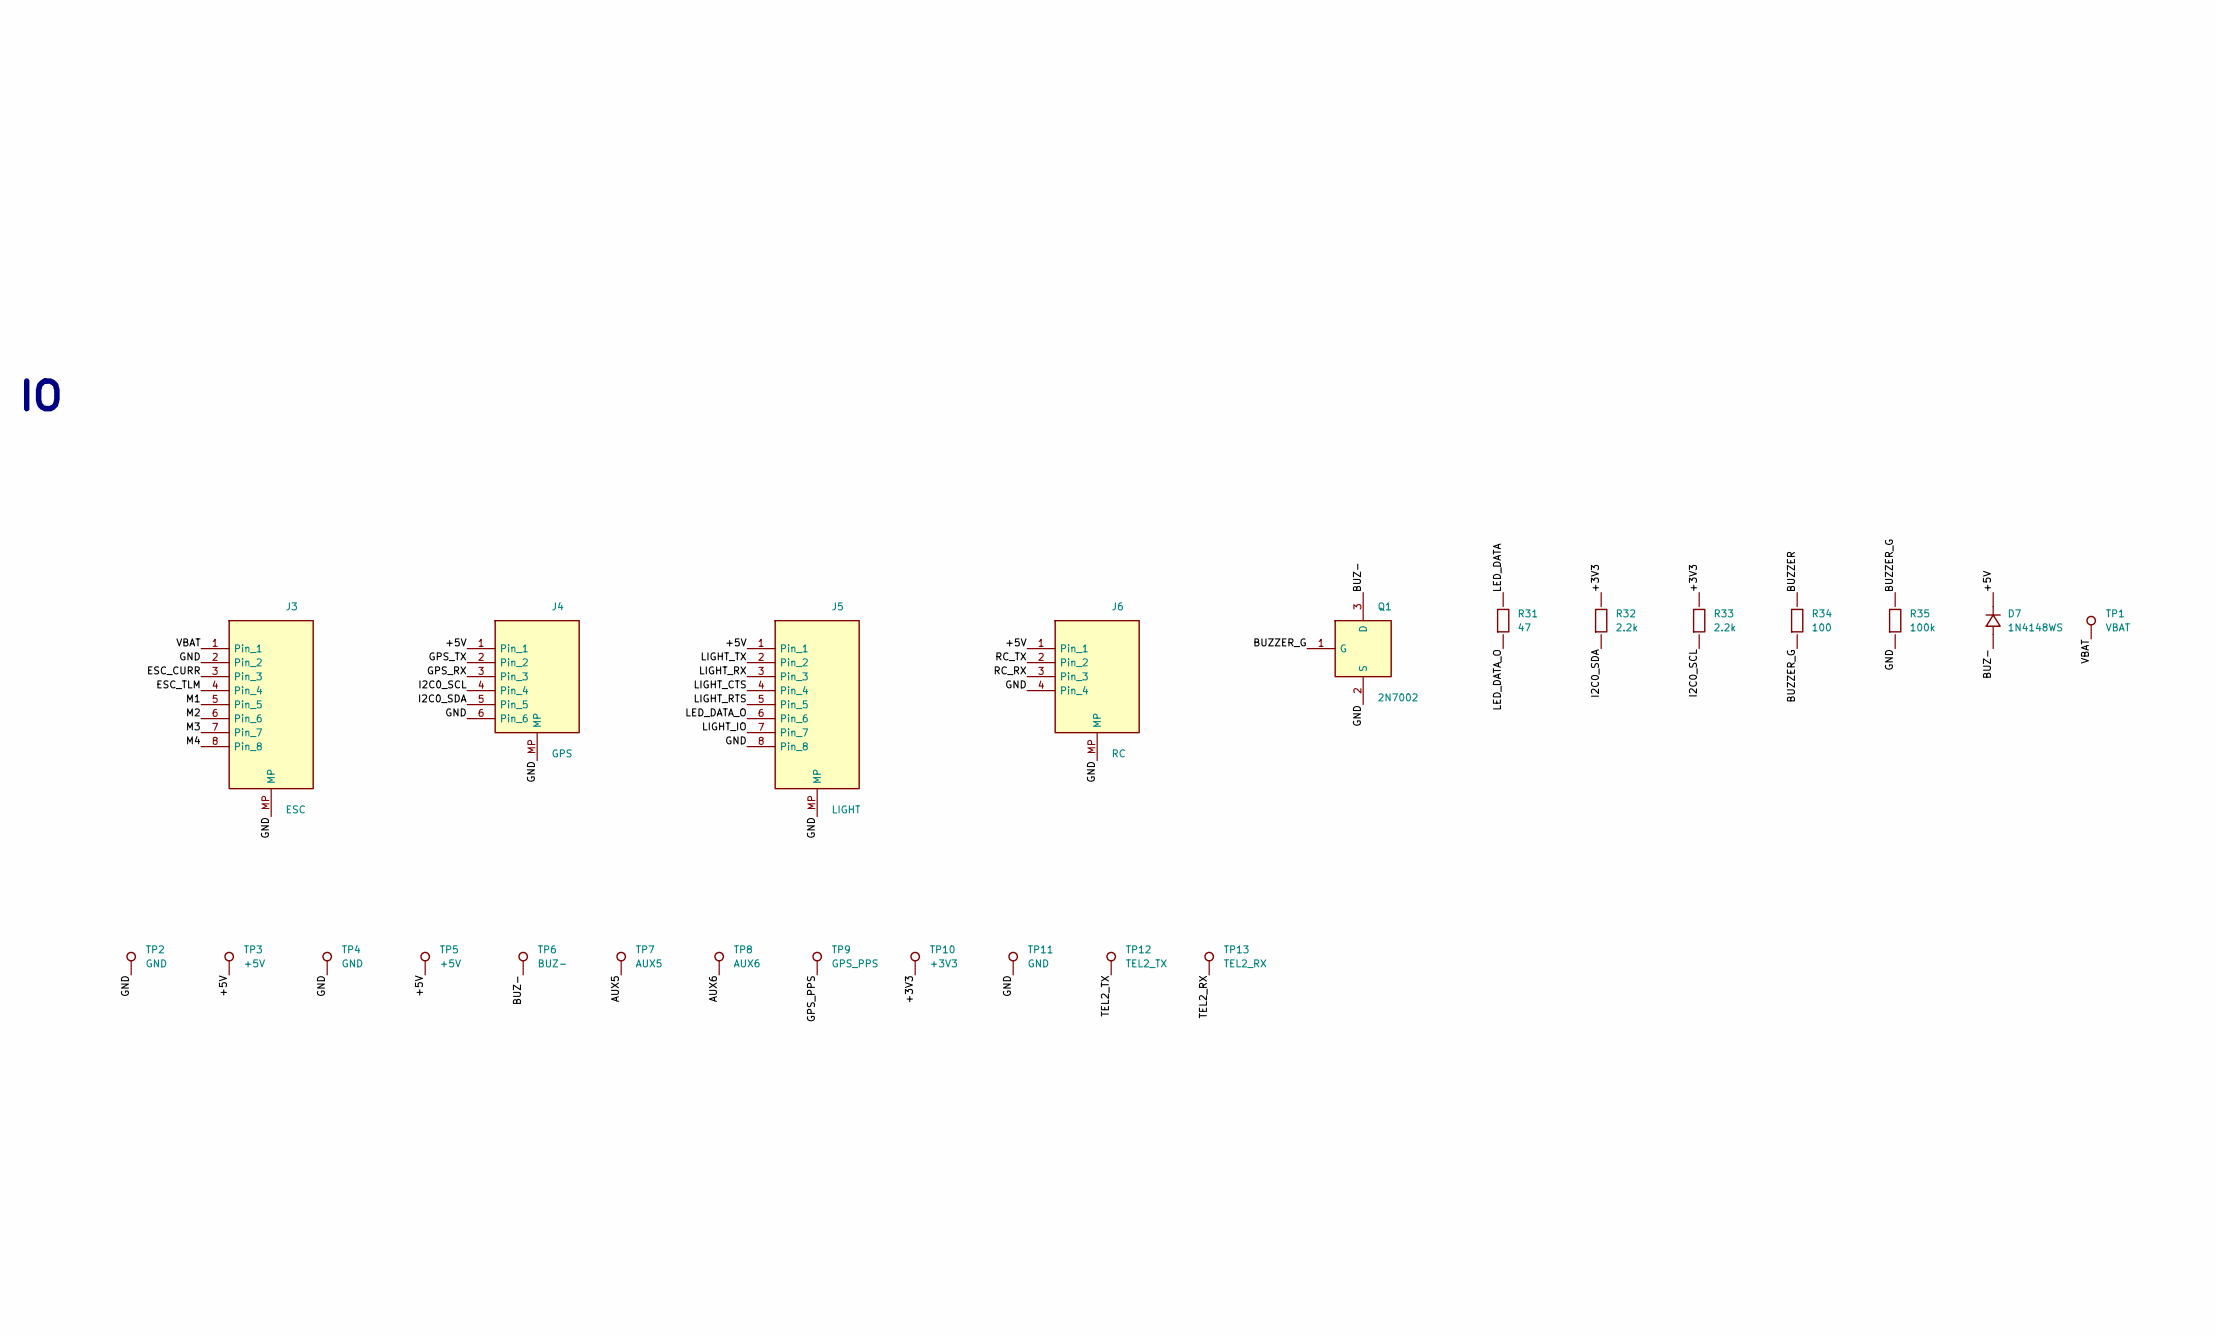
[picture p32: schematic show-fc.kicad_sch, Show FC (2-layer, RP2354B), part in row 2, column 1]

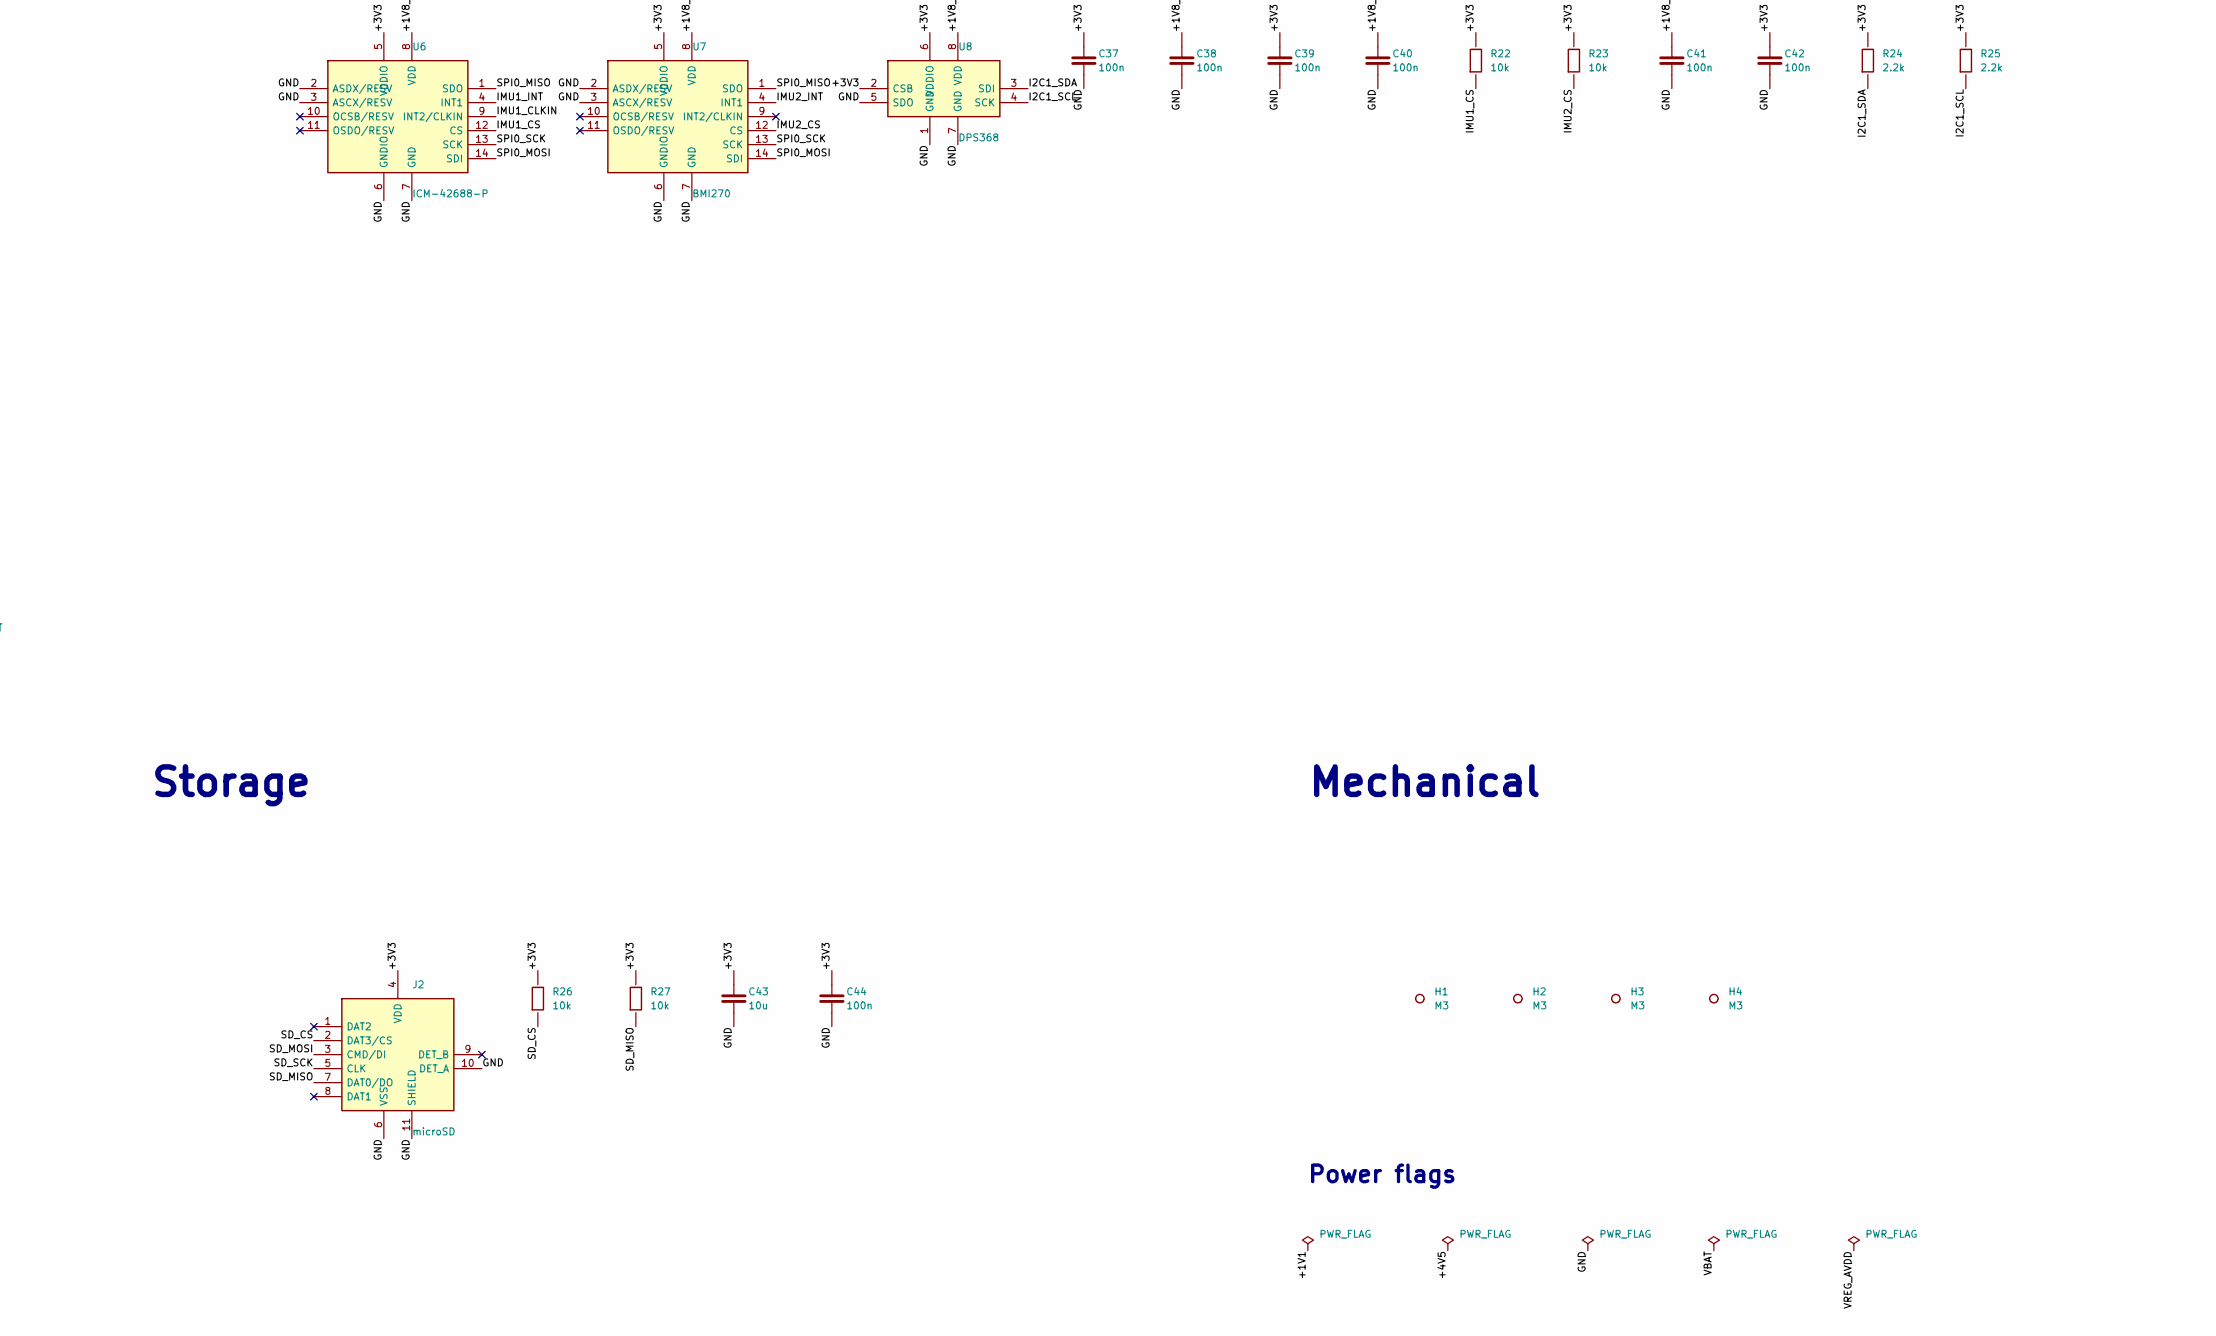
[picture p33: schematic show-fc.kicad_sch, Show FC (2-layer, RP2354B), part in row 2, column 2]

Parts:
C1, C2, C3, C4, C5, C6, C7, C8, C9, C10, C11, C15, C16, C17, C37, C38, C39, C40, C41, C42: 100n; C_0402_1005Metric; MPN GRM155R71C104KA88D
C12, C13, C14, C18, C30, C31: 4.7u; C_0603_1608Metric; MPN GRM188R61A475KE15D
C19, C20: 15p; C_0402_1005Metric; MPN GRM1555C1H150JA01D
C21, C25, C28, C33, C34, C44: 100n; C_0603_1608Metric; MPN GCM188R71H104KA57D
C22, C23: 10u 50V; C_1206_3216Metric; MPN GRM31CR61H106KA12L
C24: 100n 50V; C_0603_1608Metric; MPN GCM188R71H104KA57D
C26, C27: 22u 25V; C_1206_3216Metric; MPN GRM31CR61E226KE15L
C29, C43: 10u; C_0805_2012Metric; MPN GRM21BR61C106KE15L
C32: 1u; C_0603_1608Metric; MPN GRM188R61E105KA12D
D1: LED blue; LED_0603_1608Metric; MPN 150060BS75000
D2: LED green; LED_0603_1608Metric; MPN 150060VS75000
D3: SMF30A; D_SOD-123F; MPN SMF30A
D4, D5: PMEG3020EH; D_SOD-123F; MPN PMEG3020EH,115
D6: LED red; LED_0603_1608Metric; MPN 150060RS75000
D7: 1N4148WS; D_SOD-323; MPN 1N4148WS
H1, H2, H3, H4: M3; MountingHole_3.3mm_M3_Stack
J1: USB-C; USB_C_Receptacle_GCT_USB4105-xx-A_16P_TopMnt_Horizontal; MPN USB4105-GF-A
J2: microSD; microSD_HC_Molex_104031-0811; MPN 1040310811
J3: ESC; JST_SH_SM08B-SRSS-TB_1x08-1MP_P1.00mm_Horizontal; MPN SM08B-SRSS-TB(LF)(SN); LCSC C160407
J4: GPS; JST_GH_SM06B-GHS-TB_1x06-1MP_P1.25mm_Horizontal; MPN SM06B-GHS-TB(LF)(SN)
J5: LIGHT; JST_GH_SM08B-GHS-TB_1x08-1MP_P1.25mm_Horizontal; MPN SM08B-GHS-TB(LF)(SN)
J6: RC; JST_GH_SM04B-GHS-TB_1x04-1MP_P1.25mm_Horizontal; MPN SM04B-GHS-TB(LF)(SN)
J8: SWD; JST_SH_SM03B-SRSS-TB_1x03-1MP_P1.00mm_Horizontal; MPN SM03B-SRSS-TB(LF)(SN)
L1: 3.3uH; L_Murata_DFE201610P; MPN AOTA-B201610S3R3-101-T
L2: 4.7uH; L_Wuerth_MAPI-4020; MPN 74438357047
Q1: 2N7002; SOT-23; MPN 2N7002LT1G
R1: 33; R_0603_1608Metric; MPN RC0603FR-0733L
R2: 1k; R_0402_1005Metric; MPN RC0402FR-071KL
R3, R5, R6, R15, R18: 1k; R_0603_1608Metric; MPN RC0603FR-071KL
R4, R17, R26, R27: 10k; R_0603_1608Metric; MPN RC0603FR-0710KL
R7, R8: 5.1k; R_0603_1608Metric; MPN RC0603FR-075R1KL
R9, R10: 27; R_0402_1005Metric; MPN RC0402FR-0727L
R11, R16, R35: 100k; R_0603_1608Metric; MPN RC0603FR-07100KL
R12: 14k; R_0603_1608Metric; MPN RC0603FR-0714KL
R13: 53.6k; R_0603_1608Metric; MPN RC0603FR-0753R6KL
R14: 10.2k; R_0603_1608Metric; MPN RC0603FR-0710R2KL
R22, R23: 10k; R_0402_1005Metric; MPN RC0402FR-0710KL
R24, R25: 2.2k; R_0402_1005Metric; MPN RC0402FR-072R2KL
R31: 47; R_0603_1608Metric; MPN RC0603FR-0747L
R32, R33: 2.2k; R_0603_1608Metric; MPN RC0603FR-072R2KL
R34: 100; R_0603_1608Metric; MPN RC0603FR-07100L
SW1: BOOT; SW_SPST_B3U-1000P; MPN B3U-1000P
SW2: RESET; SW_SPST_B3U-1000P; MPN B3U-1000P
TP1: VBAT; TestPoint_Pad_D1.5mm
TP2, TP4, TP11: GND; TestPoint_Pad_D1.5mm
TP3, TP5: +5V; TestPoint_Pad_D1.5mm
TP6: BUZ-; TestPoint_Pad_D1.5mm
TP7: AUX5; TestPoint_Pad_D1.5mm
TP8: AUX6; TestPoint_Pad_D1.5mm
TP9: GPS_PPS; TestPoint_Pad_D1.5mm
TP10: +3V3; TestPoint_Pad_D1.5mm
TP12: TEL2_TX; TestPoint_Pad_D1.5mm
TP13: TEL2_RX; TestPoint_Pad_D1.5mm
U1: RP2354B; QFN-80-1EP_10x10mm_P0.4mm_EP3.4x3.4mm; MPN RP2354B; LCSC C39843328
U2: USBLC6-2SC6; SOT-23-6; MPN USBLC6-2SC6
U3: LMR51635YDDCR; SOT-23-6; MPN LMR51635YDDCR; LCSC C45262770
U4: LP5912-3.3DRVR; WSON-6-1EP_2x2mm_P0.65mm_EP1x1.6mm_ThermalVias; MPN LP5912-3.3DRVR; LCSC C524780
U5: LP5912-1.8DRVR; WSON-6-1EP_2x2mm_P0.65mm_EP1x1.6mm_ThermalVias; MPN LP5912-1.8DRVR; LCSC C2876234
U6: ICM-42688-P; LGA-14_3x2.5mm_P0.5mm; MPN ICM-42688-P
U7: BMI270; LGA-14_3x2.5mm_P0.5mm; MPN BMI270; LCSC C2836813
U8: DPS368; Infineon_VLGA-8_2.0x2.5mm_P0.65mm; MPN DPS368XTSA1
Y1: 12MHz; Crystal_SMD_3225-4Pin_3.2x2.5mm; MPN ABM8-272-T3; LCSC C20625731

Connections:
+1V1: C13.1, C15.1, C16.1, C17.1, L1.2, U1.10 (DVDD), U1.32 (DVDD), U1.51 (DVDD), U1.65 (VREG_FB)
+1V8_IMU: C31.1, C38.1, C40.1, C41.1, U5.1 (OUT), U6.8 (VDD), U7.8 (VDD), U8.8 (VDD)
+3V3: C1.1, C2.1, C3.1, C4.1, C5.1, C6.1, C7.1, C8.1, C9.1, C10.1, C11.1, C12.1, C18.1, C30.1, C37.1, C39.1, C42.1, C43.1, C44.1, J2.4 (VDD), R1.1, R4.1, R15.1, R22.1, R23.1, R24.1, R25.1, R26.1, R27.1, R32.1, R33.1, TP10.1, U1.5 (IOVDD), U1.15 (IOVDD), U1.24 (IOVDD), U1.29 (IOVDD), U1.41 (IOVDD), U1.50 (IOVDD), U1.59 (ADC_AVDD), U1.60 (IOVDD), U1.64 (VREG_VIN), U1.68 (USB_OTP_VDD), U1.69 (QSPI_IOVDD), U1.76 (IOVDD), U4.1 (OUT), U6.5 (VDDIO), U7.5 (VDDIO), U8.2 (CSB), U8.6 (VDDIO); also elsewhere on the board
+4V5: C29.1, C32.1, D4.1 (K), D5.1 (K), U4.4 (EN), U4.6 (IN), U5.4 (EN), U5.6 (IN)
+5V: C26.1, C27.1, C28.1, D4.2 (A), D7.1 (K), J4.1, J5.1, J6.1, L2.2, R13.1, TP3.1, TP5.1
ADC_CURR: C34.1, R18.2, U1.52 (GPIO41/ADC1)
ADC_VBAT: C33.1, R16.2, R17.1, U1.49 (GPIO40/ADC0)
AUX5: TP7.1, U1.47 (GPIO38)
AUX6: TP8.1, U1.48 (GPIO39)
BOOT_SW: R3.2, SW1.1
BUCK_CB: C25.1, U3.6 (CB)
BUCK_EN: R11.2, R12.1, U3.2 (EN)
BUCK_FB: R13.2, R14.1, U3.1 (FB)
BUCK_SW: C25.2, L2.1, U3.5 (SW)
BUZ-: D7.2 (A), Q1.3 (D), TP6.1
BUZZER: R34.1, U1.27 (GPIO26)
BUZZER_G: Q1.1 (G), R34.2, R35.1
ESC_CURR: J3.3, R18.1
ESC_TLM: J3.4, U1.23 (GPIO23)
GND: C1.2, C2.2, C3.2, C4.2, C5.2, C6.2, C7.2, C8.2, C9.2, C10.2, C11.2, C12.2, C13.2, C14.2, C15.2, C16.2, C17.2, C18.2, C19.2, C20.2, C21.2, C22.2, C23.2, C24.2, C26.2, C27.2, C28.2, C29.2, C30.2, C31.2, C32.2, C33.2, C34.2, C37.2, C38.2, C39.2, C40.2, C41.2, C42.2, C43.2, C44.2, D1.1 (K), D2.1 (K), D3.2 (A), D6.1 (K), J1.A1 (GND), J1.A12 (GND), J1.B1 (GND), J1.B12 (GND), J1.S1 (SHIELD), J2.6 (VSS), J2.10 (DET_A), J2.11 (SHIELD), J3.2, J3.MP, J4.6, J4.MP, J5.8, J5.MP, J6.4, J6.MP, J8.2, J8.MP, Q1.2 (S), R7.2, R8.2, R12.2, R14.2, R17.2, R35.2, SW1.2, SW2.2, TP2.1, TP4.1, TP11.1, U1.62 (VREG_PGND), U1.81 (GND), U2.2 (GND), U3.4 (GND), U4.5 (GND), U4.7 (EP), U5.5 (GND), U5.7 (EP), U6.2 (ASDX/RESV), U6.3 (ASCX/RESV), U6.6 (GNDIO), U6.7 (GND), U7.2 (ASDX/RESV), U7.3 (ASCX/RESV), U7.6 (GNDIO), U7.7 (GND), U8.1 (GND), U8.5 (SDO), U8.7 (GND), Y1.2 (GND), Y1.4 (GND); also elsewhere on the board
GPS_PPS: TP9.1, U1.22 (GPIO22)
GPS_RX: J4.3, U1.21 (GPIO21)
GPS_TX: J4.2, U1.20 (GPIO20)
I2C0_SCL: J4.4, R33.2, U1.2 (GPIO5)
I2C0_SDA: J4.5, R32.2, U1.1 (GPIO4)
I2C1_SCL: R25.2, U1.4 (GPIO7), U8.4 (SCK)
I2C1_SDA: R24.2, U1.3 (GPIO6), U8.3 (SDI)
IMU1_CLKIN: U1.14 (GPIO15), U6.9 (INT2/CLKIN)
IMU1_CS: R22.2, U1.17 (GPIO17), U6.12 (CS)
IMU1_INT: U1.13 (GPIO14), U6.4 (INT1)
IMU2_CS: R23.2, U1.11 (GPIO12), U7.12 (CS)
IMU2_INT: U1.12 (GPIO13), U7.4 (INT1)
LED_BLUE: R5.1, U1.25 (GPIO24)
LED_BLUE_A: D1.2 (A), R5.2
LED_DATA: R31.1, U1.53 (GPIO42/ADC2)
LED_DATA_O: J5.6, R31.2
LED_GREEN: R6.1, U1.26 (GPIO25)
LED_GREEN_A: D2.2 (A), R6.2
LIGHT_CTS: J5.4, U1.43 (GPIO34)
LIGHT_IO: J5.7, U1.45 (GPIO36)
LIGHT_RTS: J5.5, U1.44 (GPIO35)
LIGHT_RX: J5.3, U1.42 (GPIO33)
LIGHT_TX: J5.2, U1.40 (GPIO32)
M1: J3.5, U1.36 (GPIO28)
M2: J3.6, U1.37 (GPIO29)
M3: J3.7, U1.38 (GPIO30)
M4: J3.8, U1.39 (GPIO31)
PWR_LED_A: D6.2 (A), R15.2
QSPI_SS: R3.1, U1.75 (QSPI_SS)
RC_RX: J6.3, U1.80 (GPIO3)
RC_TX: J6.2, U1.79 (GPIO2)
RUN: C21.1, R4.2, SW2.1, U1.35 (RUN); also elsewhere on the board
SD_CS: J2.2 (DAT3/CS), R26.2, U1.7 (GPIO9)
SD_MISO: J2.7 (DAT0/DO), R27.2, U1.6 (GPIO8)
SD_MOSI: J2.3 (CMD/DI), U1.9 (GPIO11)
SD_SCK: J2.5 (CLK), U1.8 (GPIO10)
SPI0_MISO: U1.16 (GPIO16), U6.1 (SDO), U7.1 (SDO)
SPI0_MOSI: U1.19 (GPIO19), U6.14 (SDI), U7.14 (SDI)
SPI0_SCK: U1.18 (GPIO18), U6.13 (SCK), U7.13 (SCK)
SWCLK: J8.1, U1.33 (SWCLK); also elsewhere on the board
SWDIO: J8.3, U1.34 (SWDIO); also elsewhere on the board
TEL2_RX: TP13.1, U1.78 (GPIO1)
TEL2_TX: TP12.1, U1.77 (GPIO0)
USB_CC1: J1.A5 (CC1), R7.1
USB_CC2: J1.B5 (CC2), R8.1
USB_DM: R10.2, U1.66 (USB_DM)
USB_DM_C: J1.A7 (D-), J1.B7 (D-), R10.1, U2.3 (I/O2), U2.4 (I/O2)
USB_DP: R9.2, U1.67 (USB_DP)
USB_DP_C: J1.A6 (D+), J1.B6 (D+), R9.1, U2.1 (I/O1), U2.6 (I/O1)
VBAT: C22.1, C23.1, C24.1, D3.1 (K), J3.1, R11.1, R16.1, TP1.1, U3.3 (VIN)
VBUS: D5.2 (A), J1.A4 (VBUS), J1.A9 (VBUS), J1.B4 (VBUS), J1.B9 (VBUS), U2.5 (VBUS)
VREG_AVDD: C14.1, R1.2, U1.61 (VREG_AVDD)
VREG_LX: L1.1, U1.63 (VREG_LX)
XIN: C19.1, U1.30 (XIN), Y1.1 (X1)
XOUT: R2.1, U1.31 (XOUT)
XOUT_X: C20.1, R2.2, Y1.3 (X2)

Notes on the sheet:
MCU
USB
Power
Sensors
Storage
Mechanical
Power flags

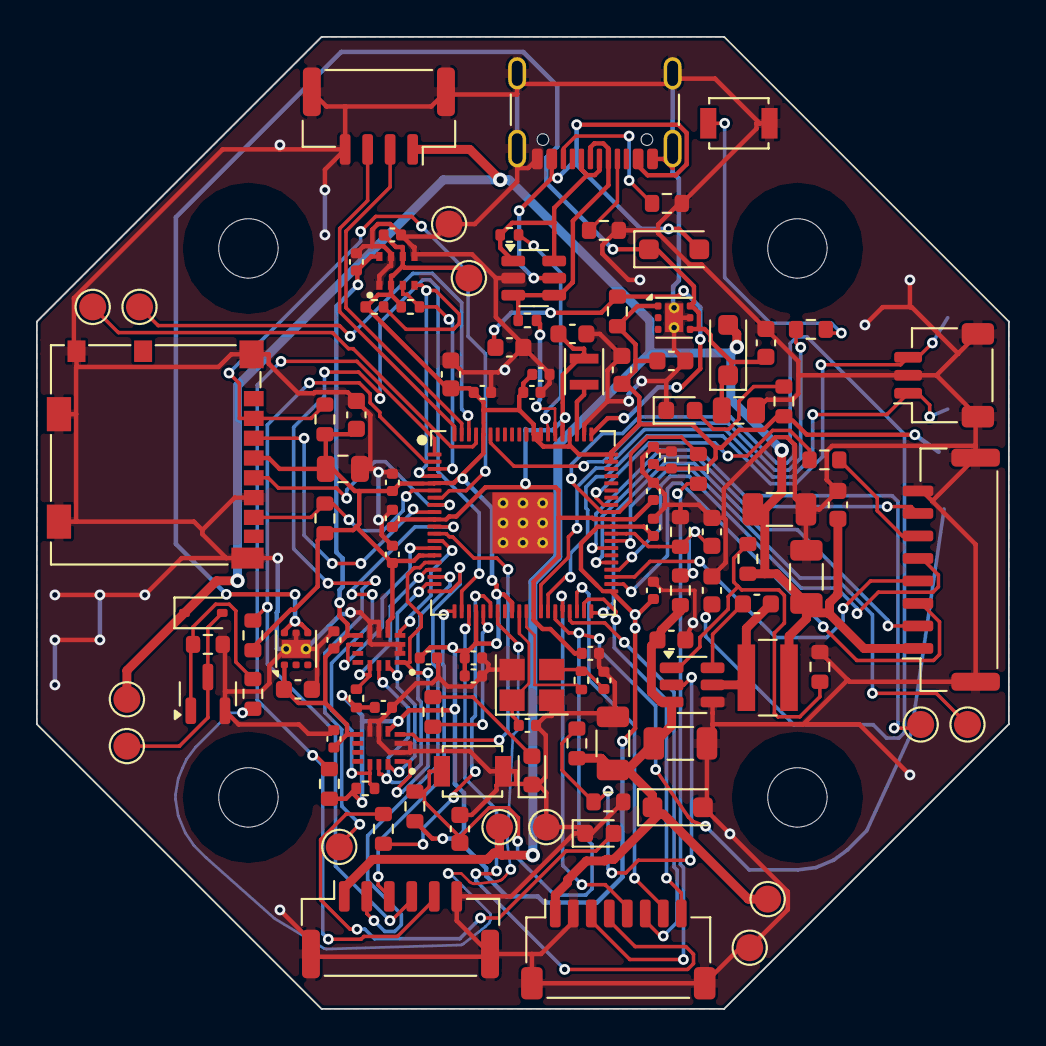
[picture p34: board show-fc.kicad_pcb from above]

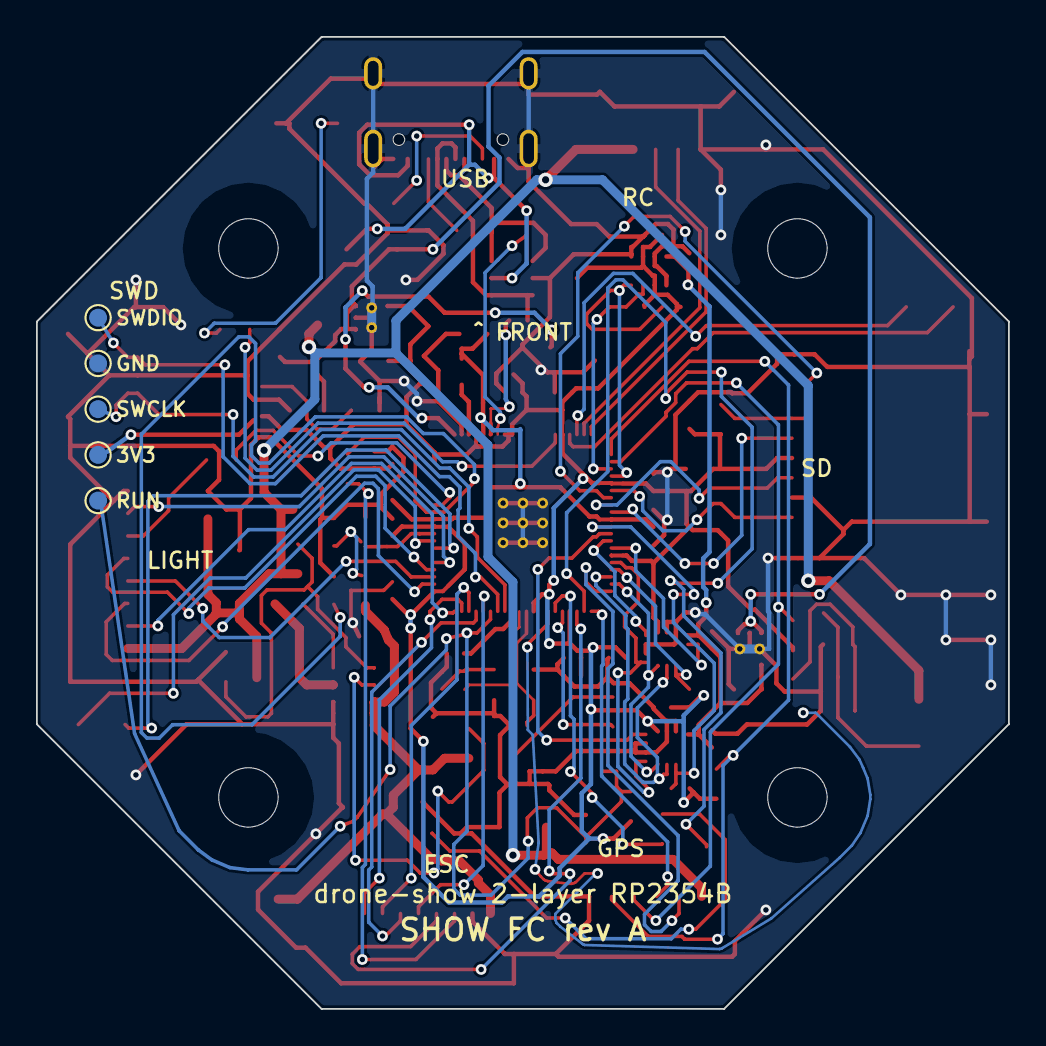
[picture p35: board show-fc.kicad_pcb from below]

Board: 2 copper layers, 54.0 x 54.0 mm, 121 parts (5 on the bottom side), 76 nets.

Other parts of the board:
TP14: SWDIO; TestPoint_Pad_D1.0mm
TP15: GND; TestPoint_Pad_D1.0mm
TP16: SWCLK; TestPoint_Pad_D1.0mm
TP17: +3V3; TestPoint_Pad_D1.0mm
TP18: RUN; TestPoint_Pad_D1.0mm

Their connections:
+3V3: TP17.1; also elsewhere on the board
GND: TP15.1; also elsewhere on the board
RUN: TP18.1; also elsewhere on the board
SWCLK: TP16.1; also elsewhere on the board
SWDIO: TP14.1; also elsewhere on the board
