benlamonica/drone-show/hardware/rtk-gps/rtk_gps.kicad_pcb

## KiCad design hardware/rtk-gps/rtk_gps.kicad_pcb (2026-10-25)

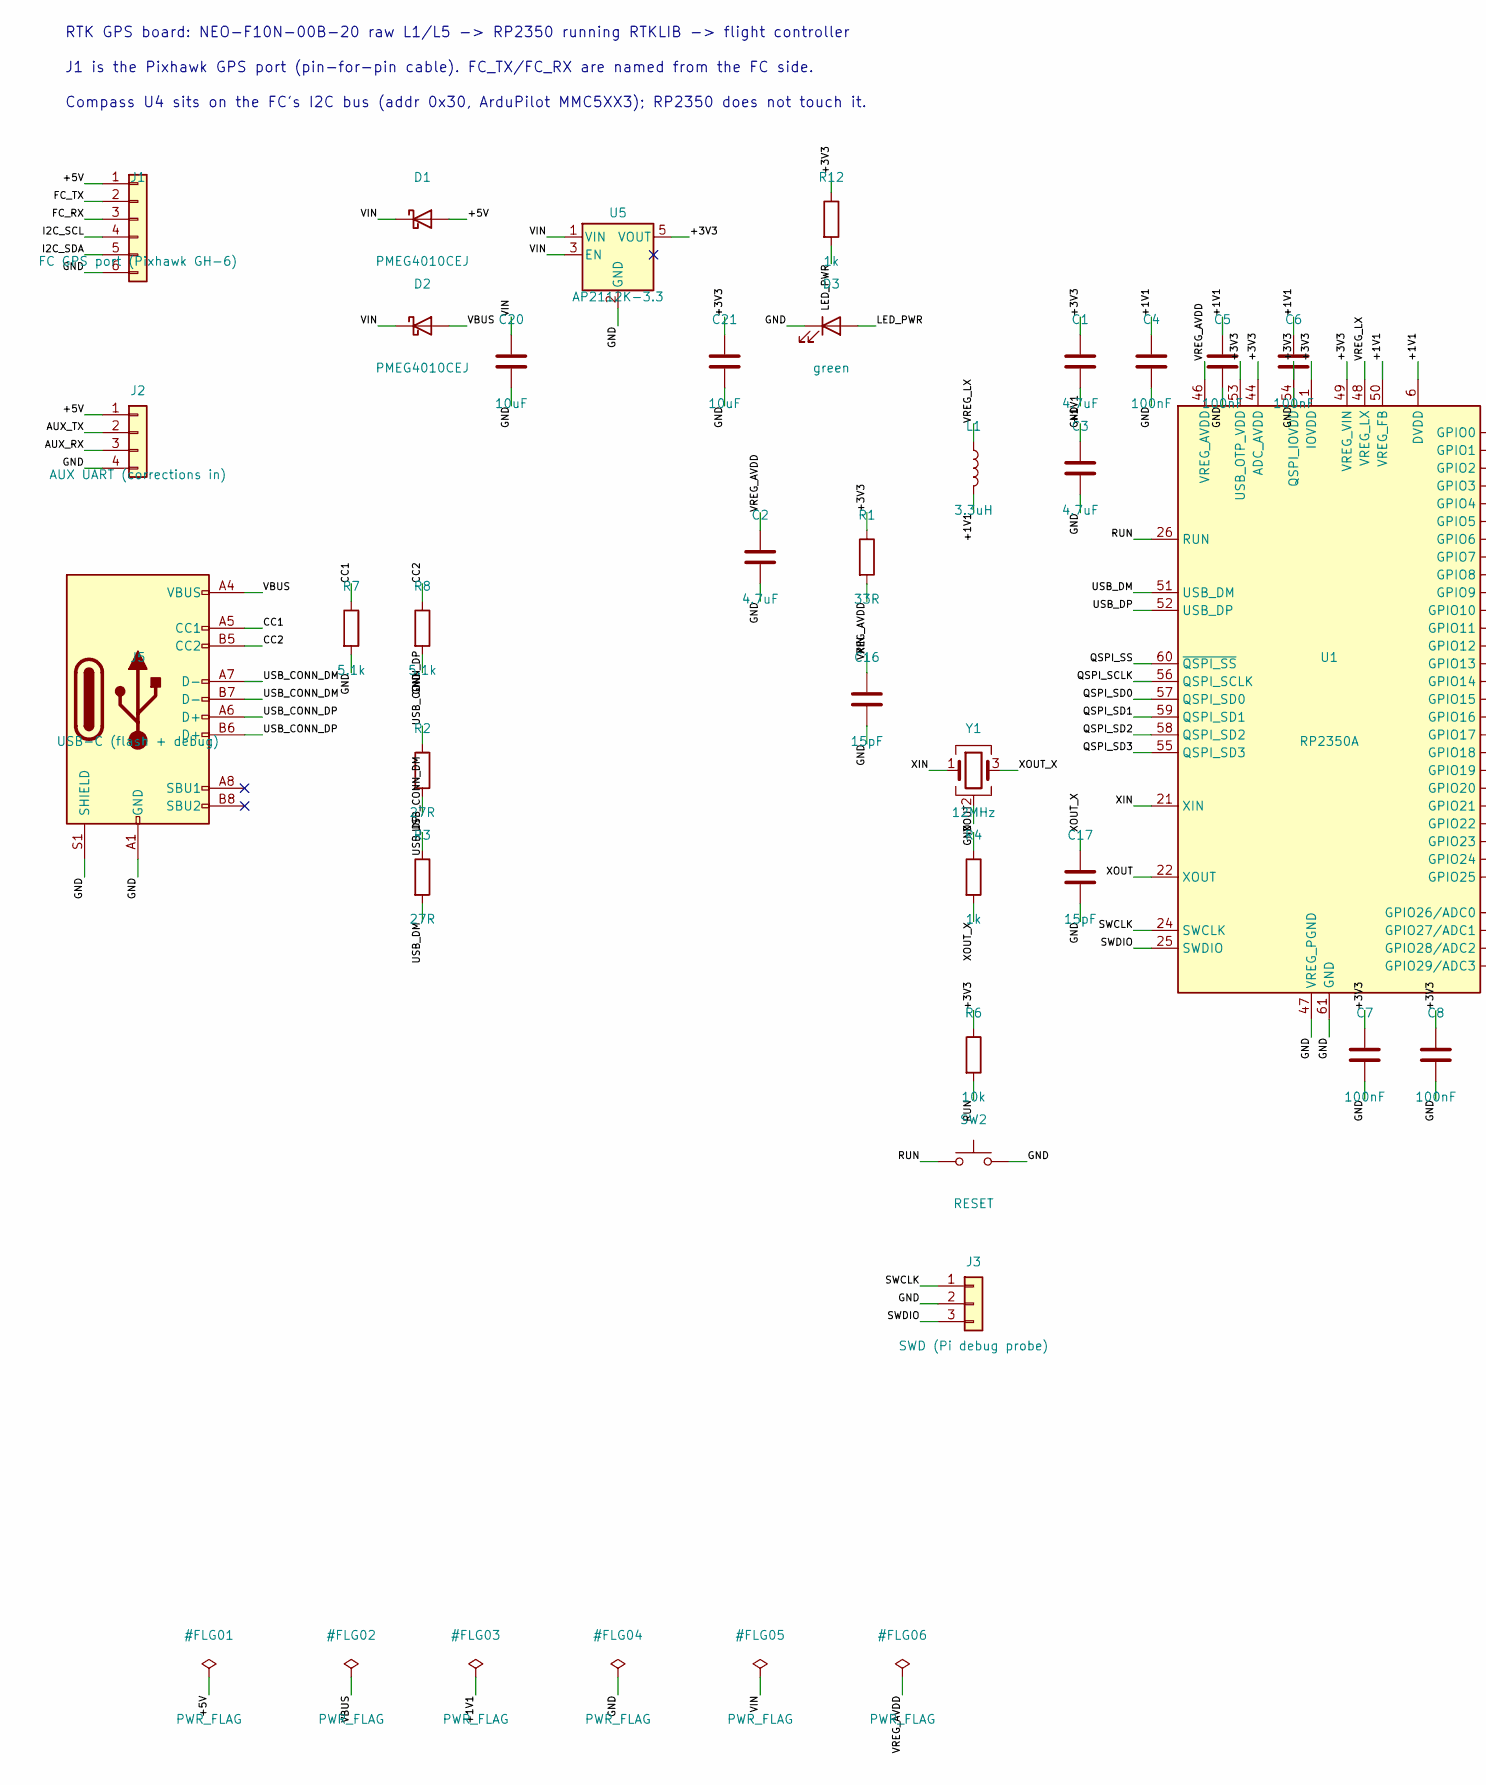
[picture p36: schematic rtk_gps.kicad_sch, RTK GPS + compass, part in row 1, column 1]

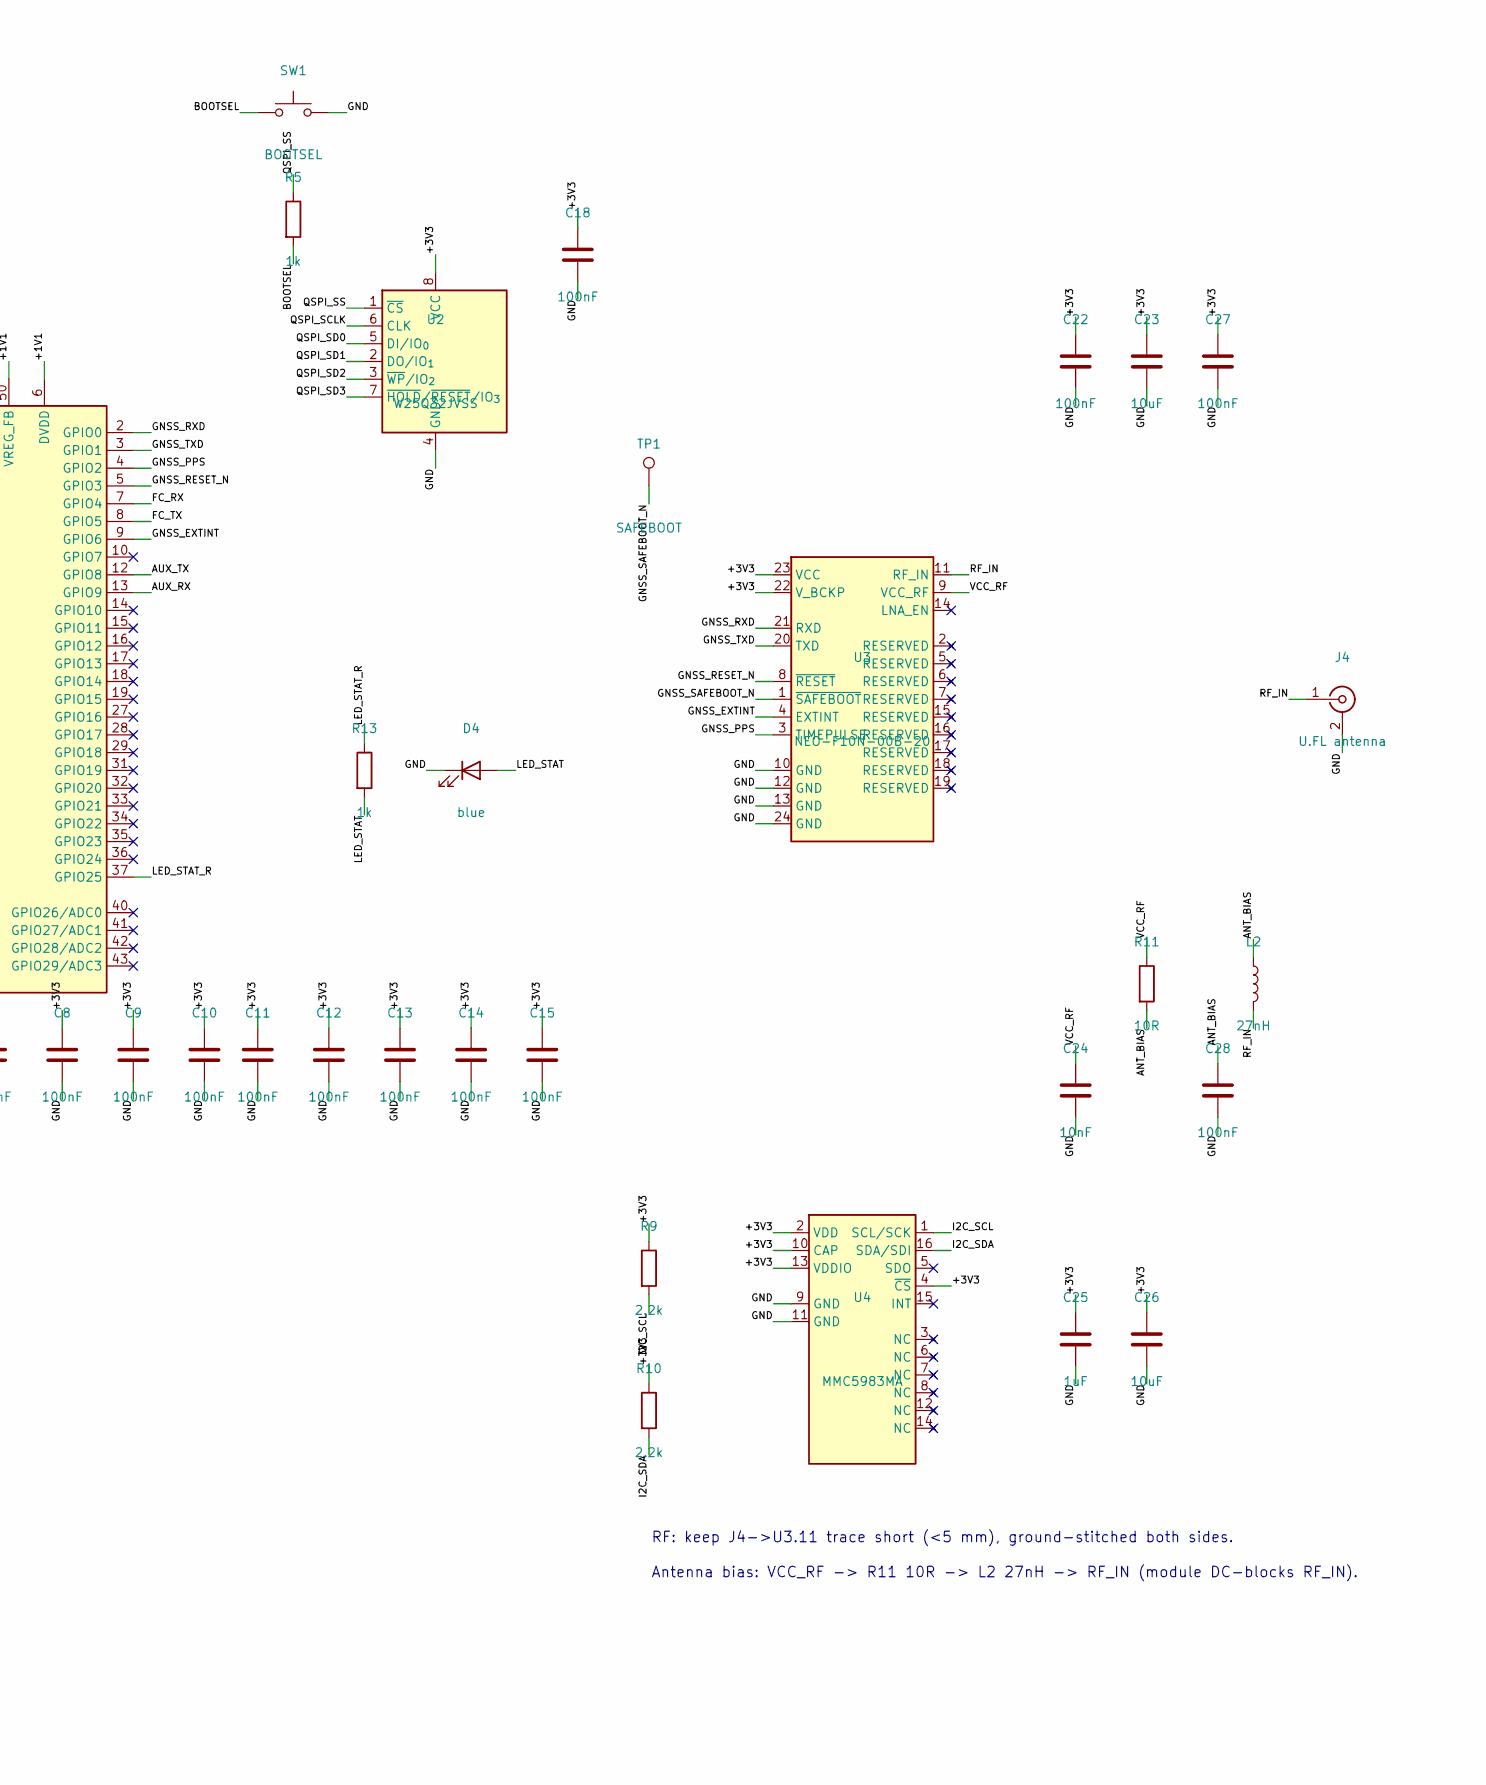
[picture p37: schematic rtk_gps.kicad_sch, RTK GPS + compass, part in row 1, column 2]

Parts:
C1, C2, C3: 4.7uF; C_0603_1608Metric; MPN CL10A475MO8NNNC; Mouser 187-CL10A475MO8NNNC
C4, C5, C6, C7, C8, C9, C10, C11, C12, C13, C14, C15, C18, C22, C27, C28: 100nF; C_0603_1608Metric; MPN CC0603KRX7R7BB104; Mouser 603-CC603KRX7R7BB104
C16, C17: 15pF; C_0603_1608Metric; MPN CC0603JRNPO9BN150; Mouser 603-CC603JRNPO9BN150
C20, C21: 10uF; C_0805_2012Metric; MPN CC0805KKX5R7BB106; Mouser 603-CC805KKX5R7BB106
C23, C26: 10uF; C_0603_1608Metric; MPN LMK107BBJ106MALT; Mouser 963-LMK107BBJ106MALT
C24: 10nF; C_0603_1608Metric; MPN CC0603KRX7R9BB103; Mouser 603-CC603KRX7R9BB103
C25: 1uF; C_0603_1608Metric; MPN CC0603KRX7R7BB105; Mouser 603-CC603KRX7R7BB105
D1, D2: PMEG4010CEJ; D_SOD-323F; MPN PMEG4010CEJ,115; Mouser 771-PMEG4010CEJ-T/R
D3: green; LED_0603_1608Metric; MPN LTST-C191KGKT; Mouser 859-LTST-C191KGKT
D4: blue; LED_0603_1608Metric; MPN LTST-C191TBKT; Mouser 859-LTST-C191TBKT
J1: FC GPS port (Pixhawk GH-6); JST_GH_SM06B-GHS-TB_1x06-1MP_P1.25mm_Horizontal; MPN SM06B-GHS-TB(LF)(SN); Mouser 306-SM06BGHSTBLFSN
J2: AUX UART (corrections in); JST_GH_SM04B-GHS-TB_1x04-1MP_P1.25mm_Horizontal; MPN SM04B-GHS-TB(LF)(SN); Mouser 306-SM04BGHSTBLFSN
J3: SWD (Pi debug probe); JST_SH_SM03B-SRSS-TB_1x03-1MP_P1.00mm_Horizontal; MPN SM03B-SRSS-TB(LF)(SN); Mouser 306-SM03BSRSSTBLFSNP
J4: U.FL antenna; U.FL_Hirose_U.FL-R-SMT-1_Vertical; MPN U.FL-R-SMT-1(10); Mouser 798-U.FL-R-SMT-1-10
J5: USB-C (flash + debug); USB_C_Receptacle_GCT_USB4105-xx-A_16P_TopMnt_Horizontal; MPN USB4105-GF-A; Mouser 640-USB4105-GF-A
L1: 3.3uH; L_Murata_DFE201610P; MPN AOTA-B201610S3R3-101-T; Mouser 815-AB201610S3R3101T
L2: 27nH; L_0603_1608Metric; MPN LQG18HN27NJ00D; Mouser 81-LQG18HN27NJ00D
R1: 33R; R_0603_1608Metric; MPN RC0603FR-0733RL; Mouser 603-RC0603FR-0733RL
R2, R3: 27R; R_0603_1608Metric; MPN RC0603FR-0727RL; Mouser 603-RC0603FR-0727RL
R4, R5, R12, R13: 1k; R_0603_1608Metric; MPN RC0603FR-071KL; Mouser 603-RC0603FR-071KL
R6: 10k; R_0603_1608Metric; MPN RC0603FR-0710KL; Mouser 603-RC0603FR-0710KL
R7, R8: 5.1k; R_0603_1608Metric; MPN RC0603FR-075K1L; Mouser 603-RC0603FR-075K1L
R9, R10: 2.2k; R_0603_1608Metric; MPN RC0603FR-072K2L; Mouser 603-RC0603FR-072K2L
R11: 10R; R_0603_1608Metric; MPN RC0603FR-0710RL; Mouser 603-RC0603FR-0710RL
SW1: BOOTSEL; SW_SPST_B3U-1000P; MPN B3U-1000P; Mouser 653-B3U-1000P
SW2: RESET; SW_SPST_B3U-1000P; MPN B3U-1000P; Mouser 653-B3U-1000P
TP1: SAFEBOOT; TestPoint_Pad_D1.0mm
U1: RP2350A; QFN-60-1EP_7x7mm_P0.4mm_EP3.4x3.4mm; MPN SC1509-A4 (RP2350A); Mouser 358-SC1509
U2: W25Q32JVSS; SOIC-8_5.3x5.3mm_P1.27mm; MPN W25Q32JVSSIQ; Mouser 454-W25Q32JVSSIQ
U3: NEO-F10N-00B-20; ublox_NEO; MPN NEO-F10N-00B-20; Mouser 377-NEO-F10N-00B-20
U4: MMC5983MA; LGA-16_3x3mm_P0.5mm; MPN MMC5983MA; Mouser 438-MMC5983MA
U5: AP2112K-3.3; SOT-23-5; MPN AP2112K-3.3TRG1; Mouser 621-AP2112K-3.3TRG1
Y1: 12MHz; Crystal_SMD_3225-4Pin_3.2x2.5mm; MPN ABM8-272-T3; Mouser 815-ABM8-272-T3

Connections:
/+1V1: C3.1, C4.1, C5.1, C6.1, L1.2, U1.6 (DVDD), U1.23 (DVDD), U1.39 (DVDD), U1.50 (VREG_FB)
/+3V3: C1.1, C7.1, C8.1, C9.1, C10.1, C11.1, C12.1, C13.1, C14.1, C15.1, C18.1, C21.1, C22.1, C23.1, C25.1, C26.1, C27.1, R1.1, R6.1, R9.1, R10.1, R12.1, U1.1 (IOVDD), U1.11 (IOVDD), U1.20 (IOVDD), U1.30 (IOVDD), U1.38 (IOVDD), U1.44 (ADC_AVDD), U1.45 (IOVDD), U1.49 (VREG_VIN), U1.53 (USB_OTP_VDD), U1.54 (QSPI_IOVDD), U2.8 (VCC), U3.22 (V_BCKP), U3.23 (VCC), U4.2 (VDD), U4.4 (~CS), U4.10 (CAP), U4.13 (VDDIO), U5.5 (VOUT)
/+5V: D1.2 (A), J1.1, J2.1
/ANT_BIAS: C28.1, L2.1, R11.2
/AUX_RX: J2.3, U1.13 (GPIO9)
/AUX_TX: J2.2, U1.12 (GPIO8)
/BOOTSEL: R5.2, SW1.1
/CC1: J5.A5 (CC1), R7.1
/CC2: J5.B5 (CC2), R8.1
/FC_RX: J1.3, U1.7 (GPIO4)
/FC_TX: J1.2, U1.8 (GPIO5)
/GND: C1.2, C2.2, C3.2, C4.2, C5.2, C6.2, C7.2, C8.2, C9.2, C10.2, C11.2, C12.2, C13.2, C14.2, C15.2, C16.2, C17.2, C18.2, C20.2, C21.2, C22.2, C23.2, C24.2, C25.2, C26.2, C27.2, C28.2, D3.1 (K), D4.1 (K), J1.6, J2.4, J3.2, J4.2 (Ext), J5.A1 (GND), J5.A12 (GND), J5.B1 (GND), J5.B12 (GND), J5.S1 (SHIELD), R7.2, R8.2, SW1.2, SW2.2, U1.47 (VREG_PGND), U1.61 (GND), U2.4 (GND), U3.10 (GND), U3.12 (GND), U3.13 (GND), U3.24 (GND), U4.9 (GND), U4.11 (GND), U5.2 (GND), Y1.2 (G), Y1.4 (G)
/GNSS_EXTINT: U1.9 (GPIO6), U3.4 (EXTINT)
/GNSS_PPS: U1.4 (GPIO2), U3.3 (TIMEPULSE)
/GNSS_RESET_N: U1.5 (GPIO3), U3.8 (~RESET)
/GNSS_RXD: U1.2 (GPIO0), U3.21 (RXD)
/GNSS_SAFEBOOT_N: TP1.1, U3.1 (~SAFEBOOT)
/GNSS_TXD: U1.3 (GPIO1), U3.20 (TXD)
/I2C_SCL: J1.4, R9.2, U4.1 (SCL/SCK)
/I2C_SDA: J1.5, R10.2, U4.16 (SDA/SDI)
/LED_PWR: D3.2 (A), R12.2
/LED_STAT: D4.2 (A), R13.2
/LED_STAT_R: R13.1, U1.37 (GPIO25)
/QSPI_SCLK: U1.56 (QSPI_SCLK), U2.6 (CLK)
/QSPI_SD0: U1.57 (QSPI_SD0), U2.5 (DI/IO_{0})
/QSPI_SD1: U1.59 (QSPI_SD1), U2.2 (DO/IO_{1})
/QSPI_SD2: U1.58 (QSPI_SD2), U2.3 (~WP/IO_{2})
/QSPI_SD3: U1.55 (QSPI_SD3), U2.7 (~HOLD/~RESET/IO_{3})
/QSPI_SS: R5.1, U1.60 (~QSPI_SS), U2.1 (~CS)
/RF_IN: J4.1 (In), L2.2, U3.11 (RF_IN)
/RUN: R6.2, SW2.1, U1.26 (RUN)
/SWCLK: J3.1, U1.24 (SWCLK)
/SWDIO: J3.3, U1.25 (SWDIO)
/USB_CONN_DM: J5.A7 (D-), J5.B7 (D-), R3.1
/USB_CONN_DP: J5.A6 (D+), J5.B6 (D+), R2.1
/USB_DM: R3.2, U1.51 (USB_DM)
/USB_DP: R2.2, U1.52 (USB_DP)
/VBUS: D2.2 (A), J5.A4 (VBUS), J5.A9 (VBUS), J5.B4 (VBUS), J5.B9 (VBUS)
/VCC_RF: C24.1, R11.1, U3.9 (VCC_RF)
/VIN: C20.1, D1.1 (K), D2.1 (K), U5.1 (VIN), U5.3 (EN)
/VREG_AVDD: C2.1, R1.2, U1.46 (VREG_AVDD)
/VREG_LX: L1.1, U1.48 (VREG_LX)
/XIN: C16.1, U1.21 (XIN), Y1.1
/XOUT: R4.1, U1.22 (XOUT)
/XOUT_X: C17.1, R4.2, Y1.3

Notes on the sheet:
RTK GPS board: NEO-F10N-00B-20 raw L1/L5 -> RP2350 running RTKLIB -> flight controller
J1 is the Pixhawk GPS port (pin-for-pin cable). FC_TX/FC_RX are named from the FC side.
Compass U4 sits on the FC's I2C bus (addr 0x30, ArduPilot MMC5XX3); RP2350 does not touch it.
RF: keep J4->U3.11 trace short (<5 mm), ground-stitched both sides.
Antenna bias: VCC_RF -> R11 10R -> L2 27nH -> RF_IN (module DC-blocks RF_IN).

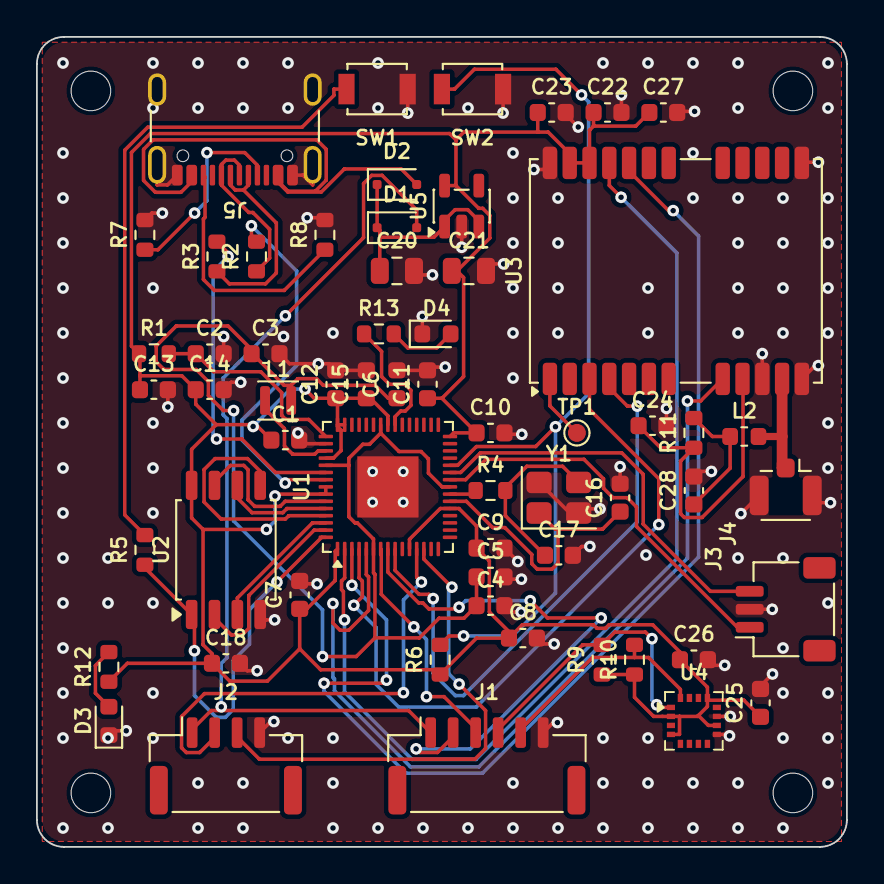
[picture p38: board rtk_gps.kicad_pcb from above]

Board: 2 copper layers, 45.0 x 45.0 mm, 64 parts (0 on the bottom side), 45 nets.

Other parts of the board:
H1, H2, H3, H4: MountingHole_2.2mm_M2
