benlamonica/drone-show/hardware/flight-controller/tools/design.py

"""Show FC: the circuit, as data.

Every part, its footprint, its order code and the net on every pin lives here.
`make_schematic.py` turns this into the KiCad schematic and symbol library,
and `make_board.py` turns the same data into the board, so the two cannot
disagree. Change the circuit here, then regenerate both.

Based on OpenFC-Lite rev3.3 (RP2354B), redesigned for a 2-layer board with
0603 or larger passives, a DPS368 barometer and show-drone I/O.
"""

from dataclasses import dataclass, field

# ---------------------------------------------------------------------------
# Footprints. Standard KiCad library where it has the part, otherwise the
# project library `showfc` (generated by make_footprints.py).

R0402 = "Resistor_SMD:R_0402_1005Metric"
R0603 = "Resistor_SMD:R_0603_1608Metric"
C0402 = "Capacitor_SMD:C_0402_1005Metric"
C0603 = "Capacitor_SMD:C_0603_1608Metric"
C0805 = "Capacitor_SMD:C_0805_2012Metric"
C1206 = "Capacitor_SMD:C_1206_3216Metric"
LED0603 = "LED_SMD:LED_0603_1608Metric"


@dataclass
class Part:
    ref: str
    kind: str            # symbol in showfc.kicad_sym
    value: str
    footprint: str
    pins: dict           # pin number -> net name ("NC" = no connect)
    mpn: str = ""
    mfr: str = ""
    lcsc: str = ""
    note: str = ""
    group: str = ""      # schematic block
    fields: dict = field(default_factory=dict)


PARTS: list[Part] = []


def add(ref, kind, value, footprint, pins, group, mpn="", mfr="", lcsc="", note=""):
    PARTS.append(Part(ref, kind, value, footprint, pins, mpn, mfr, lcsc, note, group))


def R(ref, value, a, b, group, note="", size="0603"):
    mpn = f"RC{size}FR-07{value.replace('.', 'R').upper()}L"
    add(ref, "R", value, R0402 if size == "0402" else R0603, {"1": a, "2": b}, group, mpn, "Yageo", note=note)


def C(ref, value, a, b, group, size="0603", volt="", note=""):
    fp = {"0402": C0402, "0603": C0603, "0805": C0805, "1206": C1206}[size]
    v = f"{value} {volt}".strip()
    add(ref, "C", v, fp, {"1": a, "2": b}, group, mpn=CAP_MPN.get((value, size, volt), ""), mfr="Murata", note=note)


CAP_MPN = {
    ("100n", "0402", ""): "GRM155R71C104KA88D",
    ("15p", "0402", ""): "GRM1555C1H150JA01D",
    ("100n", "0603", ""): "GCM188R71H104KA57D",
    ("100n", "0603", "50V"): "GCM188R71H104KA57D",
    ("1u", "0603", ""): "GRM188R61E105KA12D",
    ("4.7u", "0603", ""): "GRM188R61A475KE15D",
    ("10u", "0805", ""): "GRM21BR61C106KE15L",
    ("10u", "1206", "50V"): "GRM31CR61H106KA12L",
    ("22u", "1206", "25V"): "GRM31CR61E226KE15L",
    ("15p", "0603", ""): "GRM1885C1H150JA01D",
}


def LED(ref, colour, anode, cathode, group):
    mpn = {"blue": "150060BS75000", "green": "150060VS75000", "red": "150060RS75000"}[colour]
    add(ref, "LED", f"LED {colour}", LED0603, {"1": cathode, "2": anode}, group, mpn, "Wurth Elektronik")


def TP(ref, net, group, size="1.5", note=""):
    add(ref, "TP", net, f"TestPoint:TestPoint_Pad_D{size}mm", {"1": net}, group, note=note)


# ---------------------------------------------------------------------------
# MCU: RP2354B (QFN-80, 2 MB stacked flash, 48 GPIO)

G = "MCU"
MCU_PINS = {
    "1": "I2C0_SDA", "2": "I2C0_SCL", "3": "I2C1_SDA", "4": "I2C1_SCL",
    "5": "+3V3",
    "6": "SD_MISO", "7": "SD_CS", "8": "SD_SCK", "9": "SD_MOSI",
    "10": "+1V1",
    "11": "IMU2_CS", "12": "IMU2_INT", "13": "IMU1_INT", "14": "IMU1_CLKIN",
    "15": "+3V3",
    "16": "SPI0_MISO", "17": "IMU1_CS", "18": "SPI0_SCK", "19": "SPI0_MOSI",
    "20": "GPS_TX", "21": "GPS_RX", "22": "GPS_PPS", "23": "ESC_TLM",
    "24": "+3V3",
    "25": "LED_BLUE", "26": "LED_GREEN", "27": "BUZZER", "28": "NC",
    "29": "+3V3",
    "30": "XIN", "31": "XOUT",
    "32": "+1V1",
    "33": "SWCLK", "34": "SWDIO", "35": "RUN",
    "36": "M1", "37": "M2", "38": "M3", "39": "M4",
    "40": "LIGHT_TX",
    "41": "+3V3",
    "42": "LIGHT_RX", "43": "LIGHT_CTS", "44": "LIGHT_RTS", "45": "LIGHT_IO",
    "46": "NC", "47": "AUX5", "48": "AUX6",
    "49": "ADC_VBAT",
    "50": "+3V3", "51": "+1V1",
    "52": "ADC_CURR", "53": "LED_DATA", "54": "NC",
    "55": "NC", "56": "NC", "57": "NC", "58": "NC",
    "59": "+3V3",      # ADC_AVDD
    "60": "+3V3",
    "61": "VREG_AVDD", "62": "GND", "63": "VREG_LX", "64": "+3V3", "65": "+1V1",
    "66": "USB_DM", "67": "USB_DP",
    "68": "+3V3",      # USB_OTP_VDD
    "69": "+3V3",      # QSPI_IOVDD
    "70": "NC", "71": "NC", "72": "NC", "73": "NC", "74": "NC",
    "75": "QSPI_SS",
    "76": "+3V3",
    "77": "TEL2_TX", "78": "TEL2_RX", "79": "RC_TX", "80": "RC_RX",
    "81": "GND",
}
add("U1", "RP2354B", "RP2354B", "showfc:QFN-80-1EP_10x10mm_P0.4mm_EP3.4x3.4mm", MCU_PINS, G,
    "RP2354B", "Raspberry Pi", "C39843328")

# IOVDD decoupling, one per pin (5, 15, 24, 29, 41, 50, 60, 76), plus QSPI,
# USB_OTP and ADC_AVDD.
for i, pin in enumerate(["5", "15", "24", "29", "41", "50", "60", "76", "69", "68", "59"]):
    C(f"C{1 + i}", "100n", "+3V3", "GND", G, size="0402", note=f"U1 pin {pin}")
# Core regulator, RP2350 datasheet 6.3.7 figure 19.
add("L1", "L", "3.3uH", "Inductor_SMD:L_Murata_DFE201610P", {"1": "VREG_LX", "2": "+1V1"}, G,
    "AOTA-B201610S3R3-101-T", "Abracon", "",
    note="RP2350 datasheet part; the dot (pin 1) goes to VREG_LX")
C("C12", "4.7u", "+3V3", "GND", G, note="VREG_VIN")
C("C13", "4.7u", "+1V1", "GND", G, note="DVDD output")
R("R1", "33", "+3V3", "VREG_AVDD", G)
C("C14", "4.7u", "VREG_AVDD", "GND", G)
for i, pin in enumerate(["10", "32", "51"]):
    C(f"C{15 + i}", "100n", "+1V1", "GND", G, size="0402", note=f"U1 DVDD pin {pin}")
C("C18", "4.7u", "+3V3", "GND", G, note="IOVDD bulk")
# 12 MHz crystal, RP2350 hardware design guide values.
add("Y1", "XTAL4", "12MHz", "Crystal:Crystal_SMD_3225-4Pin_3.2x2.5mm",
    {"1": "XIN", "2": "GND", "3": "XOUT_X", "4": "GND"}, G, "ABM8-272-T3", "Abracon", "C20625731")
R("R2", "1k", "XOUT", "XOUT_X", G, size="0402")
C("C19", "15p", "XIN", "GND", G, size="0402")
C("C20", "15p", "XOUT_X", "GND", G, size="0402")
# Boot and reset
add("SW1", "SW", "BOOT", "Button_Switch_SMD:SW_SPST_B3U-1000P", {"1": "BOOT_SW", "2": "GND"}, G,
    "B3U-1000P", "Omron", "")
R("R3", "1k", "QSPI_SS", "BOOT_SW", G)
add("SW2", "SW", "RESET", "Button_Switch_SMD:SW_SPST_B3U-1000P", {"1": "RUN", "2": "GND"}, G,
    "B3U-1000P", "Omron", "")
R("R4", "10k", "+3V3", "RUN", G)
C("C21", "100n", "RUN", "GND", G)
# SWD, Raspberry Pi debug connector pinout (JST SH 3-pin)
add("J8", "CONN3", "SWD", "Connector_JST:JST_SH_SM03B-SRSS-TB_1x03-1MP_P1.00mm_Horizontal",
    {"1": "SWCLK", "2": "GND", "3": "SWDIO", "MP": "GND"}, G, "SM03B-SRSS-TB(LF)(SN)", "JST", "")
# Status LEDs
LED("D1", "blue", "LED_BLUE_A", "GND", G)
R("R5", "1k", "LED_BLUE", "LED_BLUE_A", G)
LED("D2", "green", "LED_GREEN_A", "GND", G)
R("R6", "1k", "LED_GREEN", "LED_GREEN_A", G)

# ---------------------------------------------------------------------------
# USB-C, device only

G = "USB"
add("J1", "USB_C", "USB-C", "Connector_USB:USB_C_Receptacle_GCT_USB4105-xx-A_16P_TopMnt_Horizontal",
    {"A1": "GND", "B12": "GND", "B1": "GND", "A12": "GND",
     "A4": "VBUS", "B9": "VBUS", "B4": "VBUS", "A9": "VBUS",
     "A5": "USB_CC1", "B5": "USB_CC2",
     "A6": "USB_DP_C", "B6": "USB_DP_C", "A7": "USB_DM_C", "B7": "USB_DM_C",
     "A8": "NC", "B8": "NC", "S1": "GND"}, G, "USB4105-GF-A", "GCT", "")
R("R7", "5.1k", "USB_CC1", "GND", G)
R("R8", "5.1k", "USB_CC2", "GND", G)
R("R9", "27", "USB_DP_C", "USB_DP", G, size="0402")
R("R10", "27", "USB_DM_C", "USB_DM", G, size="0402")
add("U2", "USBLC6", "USBLC6-2SC6", "Package_TO_SOT_SMD:SOT-23-6",
    {"1": "USB_DP_C", "2": "GND", "3": "USB_DM_C", "4": "USB_DM_C", "5": "VBUS", "6": "USB_DP_C"}, G,
    "USBLC6-2SC6", "STMicroelectronics", "")

# ---------------------------------------------------------------------------
# Power: VBAT (4S-6S, ESC connector) -> 5 V buck -> diode-OR with USB -> LDOs

G = "Power"
add("D3", "TVS", "SMF30A", "Diode_SMD:D_SOD-123F", {"1": "VBAT", "2": "GND"}, G,
    "SMF30A", "Littelfuse", "", note="unidirectional; cathode (pad 1) on VBAT, clamps ESC spikes below the buck's 60 V rating")
C("C22", "10u", "VBAT", "GND", G, size="1206", volt="50V")
C("C23", "10u", "VBAT", "GND", G, size="1206", volt="50V")
C("C24", "100n", "VBAT", "GND", G, volt="50V")
add("U3", "LMR51635", "LMR51635YDDCR", "Package_TO_SOT_SMD:SOT-23-6",
    {"1": "BUCK_FB", "2": "BUCK_EN", "3": "VBAT", "4": "GND", "5": "BUCK_SW", "6": "BUCK_CB"}, G,
    "LMR51635YDDCR", "Texas Instruments", "C45262770")
R("R11", "100k", "VBAT", "BUCK_EN", G, note="UVLO ~10 V")
R("R12", "14k", "BUCK_EN", "GND", G)
C("C25", "100n", "BUCK_CB", "BUCK_SW", G)
add("L2", "L", "4.7uH", "Inductor_SMD:L_Wuerth_MAPI-4020", {"1": "BUCK_SW", "2": "+5V"}, G,
    "74438357047", "Wurth Elektronik", "")
R("R13", "53.6k", "+5V", "BUCK_FB", G)
R("R14", "10.2k", "BUCK_FB", "GND", G)
C("C26", "22u", "+5V", "GND", G, size="1206", volt="25V")
C("C27", "22u", "+5V", "GND", G, size="1206", volt="25V")
C("C28", "100n", "+5V", "GND", G)
# Diode-OR of the 5 V buck and USB into +4V5 (same arrangement as OpenFC-Lite)
add("D4", "D", "PMEG3020EH", "Diode_SMD:D_SOD-123F", {"1": "+4V5", "2": "+5V"}, G,
    "PMEG3020EH,115", "Nexperia", "")
add("D5", "D", "PMEG3020EH", "Diode_SMD:D_SOD-123F", {"1": "+4V5", "2": "VBUS"}, G,
    "PMEG3020EH,115", "Nexperia", "")
C("C29", "10u", "+4V5", "GND", G, size="0805")
add("U4", "LP5912", "LP5912-3.3DRVR", "Package_SON:WSON-6-1EP_2x2mm_P0.65mm_EP1x1.6mm_ThermalVias",
    {"1": "+3V3", "2": "NC", "3": "NC", "4": "+4V5", "5": "GND", "6": "+4V5", "7": "GND"}, G,
    "LP5912-3.3DRVR", "Texas Instruments", "C524780")
C("C30", "4.7u", "+3V3", "GND", G)
add("U5", "LP5912", "LP5912-1.8DRVR", "Package_SON:WSON-6-1EP_2x2mm_P0.65mm_EP1x1.6mm_ThermalVias",
    {"1": "+1V8_IMU", "2": "NC", "3": "NC", "4": "+4V5", "5": "GND", "6": "+4V5", "7": "GND"}, G,
    "LP5912-1.8DRVR", "Texas Instruments", "C2876234",
    note="clean supply for the IMU and barometer cores")
C("C31", "4.7u", "+1V8_IMU", "GND", G)
C("C32", "1u", "+4V5", "GND", G)
LED("D6", "red", "PWR_LED_A", "GND", G)
R("R15", "1k", "+3V3", "PWR_LED_A", G)
# Analog sense
R("R16", "100k", "VBAT", "ADC_VBAT", G, note="VBAT / 11, ArduPilot BATT_VOLT_MULT 11.0")
R("R17", "10k", "ADC_VBAT", "GND", G)
C("C33", "100n", "ADC_VBAT", "GND", G)
R("R18", "1k", "ESC_CURR", "ADC_CURR", G)
C("C34", "100n", "ADC_CURR", "GND", G)

# ---------------------------------------------------------------------------
# Sensors: two IMUs on SPI0, DPS368 barometer on I2C1

G = "Sensors"
IMU_COMMON = {"2": "GND", "3": "GND", "6": "GND", "7": "GND", "10": "NC", "11": "NC",
              "5": "+3V3", "8": "+1V8_IMU",
              "1": "SPI0_MISO", "13": "SPI0_SCK", "14": "SPI0_MOSI"}
add("U6", "IMU_LGA14", "ICM-42688-P", "showfc:LGA-14_3x2.5mm_P0.5mm",
    {**IMU_COMMON, "4": "IMU1_INT", "9": "IMU1_CLKIN", "12": "IMU1_CS"}, G,
    "ICM-42688-P", "TDK InvenSense", "",
    note="IMU1; pin 9 is CLKIN, driven by a 32 kHz PWM from GPIO15")
add("U7", "IMU_LGA14", "BMI270", "showfc:LGA-14_3x2.5mm_P0.5mm",
    {**IMU_COMMON, "4": "IMU2_INT", "9": "NC", "12": "IMU2_CS"}, G,
    "BMI270", "Bosch Sensortec", "C2836813", note="IMU2, different vendor for redundancy")
for i, (a, note) in enumerate([("+3V3", "U6 VDDIO"), ("+1V8_IMU", "U6 VDD"),
                               ("+3V3", "U7 VDDIO"), ("+1V8_IMU", "U7 VDD")]):
    C(f"C{37 + i}", "100n", a, "GND", G, size="0402", note=note)
R("R22", "10k", "+3V3", "IMU1_CS", G, size="0402")
R("R23", "10k", "+3V3", "IMU2_CS", G, size="0402")
add("U8", "DPS368", "DPS368", "showfc:Infineon_VLGA-8_2.0x2.5mm_P0.65mm",
    {"1": "GND", "2": "+3V3", "3": "I2C1_SDA", "4": "I2C1_SCL", "5": "GND",
     "6": "+3V3", "7": "GND", "8": "+1V8_IMU"}, G,
    "DPS368XTSA1", "Infineon", "",
    note="I2C address 0x76 (SDO low), CSB high selects I2C. Cover with open-cell foam.")
C("C41", "100n", "+1V8_IMU", "GND", G, size="0402", note="U8 VDD")
C("C42", "100n", "+3V3", "GND", G, size="0402", note="U8 VDDIO")
R("R24", "2.2k", "+3V3", "I2C1_SDA", G, size="0402")
R("R25", "2.2k", "+3V3", "I2C1_SCL", G, size="0402")

# ---------------------------------------------------------------------------
# microSD (logs and the show file) on SPI1

G = "Storage"
add("J2", "MICROSD", "microSD", "Connector_Card:microSD_HC_Molex_104031-0811",
    {"1": "NC", "2": "SD_CS", "3": "SD_MOSI", "4": "+3V3", "5": "SD_SCK", "6": "GND",
     "7": "SD_MISO", "8": "NC", "9": "NC", "10": "GND", "11": "GND"}, G,
    "1040310811", "Molex", "")
# DAT1 and DAT2 are unused in SPI mode. Card detect is left unconnected: on a 2-layer board it has no clear path to the MCU, and the flight software does not need it.
R("R26", "10k", "+3V3", "SD_CS", G)
R("R27", "10k", "+3V3", "SD_MISO", G)
C("C43", "10u", "+3V3", "GND", G, size="0805")
C("C44", "100n", "+3V3", "GND", G)

# ---------------------------------------------------------------------------
# Connectors and pads

G = "IO"
GH = "Connector_JST:JST_GH_SM0{n}B-GHS-TB_1x0{n}-1MP_P1.25mm_Horizontal"
add("J3", "CONN8", "ESC", "Connector_JST:JST_SH_SM08B-SRSS-TB_1x08-1MP_P1.00mm_Horizontal",
    {"1": "VBAT", "2": "GND", "3": "ESC_CURR", "4": "ESC_TLM", "5": "M1", "6": "M2", "7": "M3",
     "8": "M4", "MP": "GND"}, G, "SM08B-SRSS-TB(LF)(SN)", "JST", "C160407",
    note="Betaflight standard ESC pinout, same as OpenFC-Lite P1")
add("J4", "CONN6", "GPS", GH.format(n=6),
    {"1": "+5V", "2": "GPS_TX", "3": "GPS_RX", "4": "I2C0_SCL", "5": "I2C0_SDA", "6": "GND",
     "MP": "GND"}, G, "SM06B-GHS-TB(LF)(SN)", "JST", "",
    note="Pixhawk GPS1 pinout: RTK board with compass")
add("J5", "CONN8", "LIGHT", GH.format(n=8),
    {"1": "+5V", "2": "LIGHT_TX", "3": "LIGHT_RX", "4": "LIGHT_CTS", "5": "LIGHT_RTS",
     "6": "LED_DATA_O", "7": "LIGHT_IO", "8": "GND", "MP": "GND"}, G,
    "SM08B-GHS-TB(LF)(SN)", "JST", "",
    note="light / Wi-Fi board: MAVLink UART with flow control, LED data, GPIO")
add("J6", "CONN4", "RC", GH.format(n=4),
    {"1": "+5V", "2": "RC_TX", "3": "RC_RX", "4": "GND", "MP": "GND"}, G,
    "SM04B-GHS-TB(LF)(SN)", "JST", "", note="CRSF / SBUS receiver for the safety pilot")
R("R31", "47", "LED_DATA", "LED_DATA_O", G)
I2C0_PULL = [("R32", "I2C0_SDA"), ("R33", "I2C0_SCL")]
for ref, net in I2C0_PULL:
    R(ref, "2.2k", "+3V3", net, G)
# Buzzer driver, 5 V buzzer between BUZ+ (5 V) and BUZ-
add("Q1", "NMOS", "2N7002", "Package_TO_SOT_SMD:SOT-23", {"1": "BUZZER_G", "2": "GND", "3": "BUZ-"}, G,
    "2N7002LT1G", "onsemi", "")
R("R34", "100", "BUZZER", "BUZZER_G", G)
R("R35", "100k", "BUZZER_G", "GND", G)
add("D7", "D", "1N4148WS", "Diode_SMD:D_SOD-323", {"1": "+5V", "2": "BUZ-"}, G,
    "1N4148WS", "onsemi", "")
# Solder pads
for i, (net, size) in enumerate([("VBAT", "1.5"), ("GND", "1.5"), ("+5V", "1.5"), ("GND", "1.5"),
                                 ("+5V", "1.5"), ("BUZ-", "1.5"), ("AUX5", "1.5"), ("AUX6", "1.5"),
                                 ("GPS_PPS", "1.5"), ("+3V3", "1.5"), ("GND", "1.5"),
                                 ("TEL2_TX", "1.5"), ("TEL2_RX", "1.5")]):
    TP(f"TP{1 + i}", net, G, size)
# SWD debug pads, bottom side next to J8, for a pogo-pin or clip debugger
# without the JST cable
for i, net in enumerate(["SWDIO", "GND", "SWCLK", "+3V3", "RUN"]):
    TP(f"TP{14 + i}", net, G, "1.0", note="SWD debug pad, bottom side")

# Mounting holes, 30.5 mm stack (frame STACK_SPACING), isolated
for i in range(4):
    add(f"H{1 + i}", "HOLE", "M3", "showfc:MountingHole_3.3mm_M3_Stack", {}, "Mechanical")


# ---------------------------------------------------------------------------
def nets():
    out = {}
    for p in PARTS:
        for pin, net in p.pins.items():
            if net != "NC":
                out.setdefault(net, []).append((p.ref, pin))
    return out


if __name__ == "__main__":
    n = nets()
    print(len(PARTS), "parts,", len(n), "nets")
    for net, pins in sorted(n.items()):
        if len(pins) < 2:
            print("single-pin net:", net, pins)
