benlamonica/drone-show/(commit log)

2026-09-21 initial commit of pico implementation of a gps rtk resolver that uses gps+glonass.
2026-10-24 light-controller: schematic, local library, placed board, PCBWay rules (WIP)
    Claude-Session: https://claude.ai/code/session_01KXRTPSv3xMSgDNs8D9aXZS
2026-10-24 light-controller: LED array per colour row, no USB, routing tools, README (WIP)
    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
2026-10-24 Show FC: routing pipeline, 54 mm board, PCBWay rules and README (routing in progress)
    Adds the Freerouting pipeline (route.py), fab export (make_fab.py), the
    PCBWay .kicad_dru and the README. Widens the flats to 54 mm (corners
    still 27 mm), remaps LED data to GPIO42, moves the AUX and TELEM2 pads
    next to their pins and drops SD card detect.
    Claude-Session: https://claude.ai/code/session_01BR3A1ZEFbsPLQy3Mn5HNY3
2026-10-24 Show FC: routed 54 mm board (4 connections left), stacking holes, fab outputs
    Routes the 2-layer board with Freerouting plus a second pass (finish.py);
    four connections remain for KiCad's interactive router, listed in the
    README. Mounting holes follow the shared stack spec (3.3 mm unplated,
    30.5 mm pattern, 7.5 mm copper-free ring). Adds Gerbers, drill, CPL and
    BOM in fab/ and board renders.
    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
2026-10-24 light-controller: finish routing, pass DRC, add fab outputs
    All nets routed on 2 layers with 0 DRC errors against the PCBWay rules
    (silkscreen warnings only). Ground islands are stitched to the main pour,
    leftover rip-up stubs are removed, and the board netlist matches design.py
    pad for pad. Adds the gerber zip, BOM and placement file for PCBWay, fresh
    renders, and README notes on DRC, spare pins and the status LED.
    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
2026-10-25 Show FC: finish routing, add SWD debug pads, move project to KiCad 10
    - Upgrade schematic, board and project to the KiCad 10 format. The schematic
    now uses global labels so its net names match the board's, and the TP
    symbol pin sits on the 1.27 mm grid; ERC is clean.
    - Route the last four connections by hand:
    XOUT from U1.31 between XIN and +1V1, under Y1 to R2 (XIN narrowed to 0.15);
    USB_DP from R9 through a via inside the U2 loop, bottom layer to a via over
    U1.67 (USB_DM via and the +1V1 core link moved to make room);
    VBAT by swapping R16 and R17, so R16's VBAT pad sits beside C24;
    BUZZER from U1.27 around the mounting holes on the bottom layer to R34.
    - Add five 1 mm SWD deb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
2026-10-25 initial board layouts for rtk-gps board and flight controllers, as well as a fix for the gps-rtk library found while testing.
2026-10-26 light-controller: vertical SWD connector so the probe plugs in from below
    The horizontal JST-SH on the bottom opened toward the middle of the board,
    so the probe plug and cable ran into the parts around it, and the long edges
    are inside the rail so it can't face outward. J3 is now a BM03B-SRSS-TB
    vertical with the signal pads where they were; SWCLK, SWDIO and GPIO11 are
    re-routed around it. DRC still 0 errors.
    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
2026-10-26 light-controller: drop the SWD connector, program through pogo-pin pads
    J3 is gone. SWCLK, GND and SWDIO are now test pads TP5-TP7 in the same
    2.6 mm row as RUN and the spare GPIOs, so one pogo jig reaches all seven.
    GPIO10/11 and the SWD nets are re-routed around the new pads; DRC is
    still 0 errors and the netlist matches design.py.
    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
2026-11-03 light-controller: build with the RP2354A, leave the external flash off
    U2 is now the RP2354A (an RP2350A with 2 MB of flash in the package), so
    U3 (W25Q16) and its decoupling cap C29 are marked do-not-fit and drop out
    of the BOM and placement file. The footprints stay on the board in case
    someone builds it with a plain RP2350A. No copper changes; DRC unchanged.
    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
2026-11-03 light-controller: L1 is the Laird TYA4020, pads widened to fit it
    The Laird TYA40206R8M-10's terminals sit at the body edges (1.0 mm wide,
    2.0 mm apart), outside the Coilcraft XAL4020 lands. L1 gets a new 4020
    footprint with 1.6 x 3.6 mm pads at +-1.5 mm that fully cover either
    part. No other copper moved; DRC is still 0 errors.
    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
2026-11-04 light-controller: thermal limits for the enclosed board
    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
2026-11-08 adjust text on light-controller board.
2026-11-09 pico: add wifi_bridge, a Wi-Fi MAVLink bridge firmware
    Forwards MAVLink between UART0 (GP0/GP1) and UDP 14550, on the light
    controller's flight controller pins. The Wi-Fi network is given at
    configure time, and the target is skipped without it.
    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
2026-11-13 pico: run wifi_bridge's flight controller link at 460800
    The OpenFC-Lite-Mini's PIO UART has no baud ceiling at this rate (225 MHz
    clock divides to 61.04, under 0.1 % error), and 460800 is four times the
    115200 link.
    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
