benlamonica/drone-show/(notices)

Notices in the files:
hardware/flight-controller/show-fc.kicad_sch:
Derived from OpenFC-Lite rev3.3 (CERN-OHL-S-2.0)
